mattbrejza/cubesat-pwr/board/power-board.brd

## EAGLE design board/power-board.brd (2018-11-06)

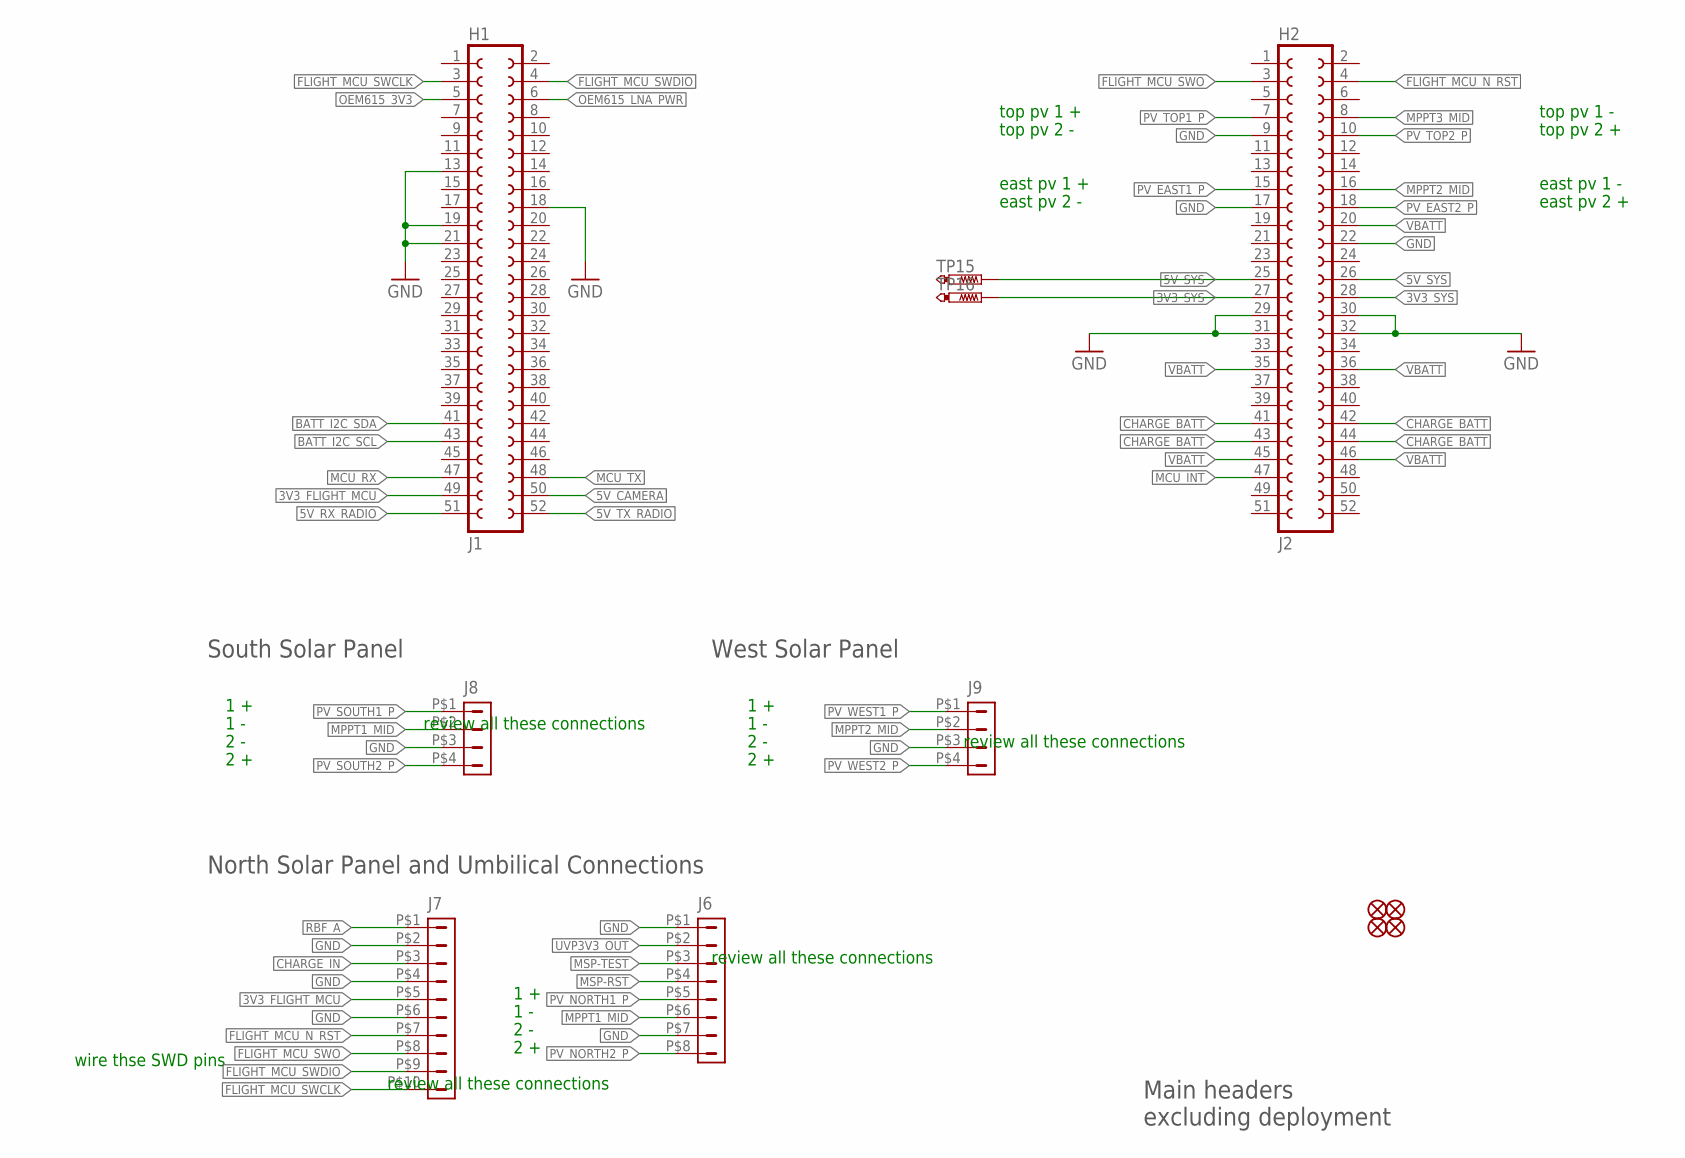
[picture p1: schematic power-board.sch, sheet 1, Headers H1, H2, Solar Panels and Umbilical Connection]

Parts:
FID1, FID2, FID3, FID4: FIDUCIAL1X2-STOP; FIDUCIAL-1X2-STOP
J1: H1; FE26-2
J2: H2; FE26-2
J6: DF13-8P-1.25DS
J7: DF13-10P-1.25DS
J8, J9: DF13-4P-1.25DS
TP15, TP16: PTR1TP09R; TP09R

Connections:
3V3_FLIGHT_MCU: J1.49, J7.P$5 (5); also elsewhere on the board
3V3_SYS: J2.27, J2.28, TP16.TP; also elsewhere on the board
5V_CAMERA: J1.50; also elsewhere on the board
5V_RX_RADIO: J1.51; also elsewhere on the board
5V_SYS: J2.25, J2.26, TP15.TP; also elsewhere on the board
5V_TX_RADIO: J1.52; also elsewhere on the board
BATT_I2C_SCL: J1.43; also elsewhere on the board
BATT_I2C_SDA: J1.41; also elsewhere on the board
CHARGE_BATT: J2.41, J2.42, J2.43, J2.44; also elsewhere on the board
CHARGE_IN: J7.P$3 (3); also elsewhere on the board
FLIGHT_MCU_N_RST: J2.4, J7.P$7 (7)
FLIGHT_MCU_SWCLK: J1.3, J7.P$10 (10)
FLIGHT_MCU_SWDIO: J1.4, J7.P$9 (9)
FLIGHT_MCU_SWO: J2.3, J7.P$8 (8)
GND: J1.13, J1.18, J1.19, J1.21, J2.9, J2.17, J2.22, J2.29, J2.30, J2.31, J2.32, J6.P$1 (1), J6.P$7 (7), J7.P$2 (2), J7.P$4 (4), J7.P$6 (6), J8.P$3 (3), J9.P$3 (3); also elsewhere on the board
MCU_INT: J2.47; also elsewhere on the board
MCU_RX: J1.47; also elsewhere on the board
MCU_TX: J1.48; also elsewhere on the board
MPPT1_MID: J6.P$6 (6), J8.P$2 (2); also elsewhere on the board
MPPT2_MID: J2.16, J9.P$2 (2); also elsewhere on the board
MPPT3_MID: J2.8; also elsewhere on the board
MSP-RST: J6.P$4 (4); also elsewhere on the board
MSP-TEST: J6.P$3 (3); also elsewhere on the board
OEM615_3V3: J1.5; also elsewhere on the board
OEM615_LNA_PWR: J1.6; also elsewhere on the board
PV_EAST1_P: J2.15; also elsewhere on the board
PV_EAST2_P: J2.18; also elsewhere on the board
PV_NORTH1_P: J6.P$5 (5); also elsewhere on the board
PV_NORTH2_P: J6.P$8 (8); also elsewhere on the board
PV_SOUTH1_P: J8.P$1 (1); also elsewhere on the board
PV_SOUTH2_P: J8.P$4 (4); also elsewhere on the board
PV_TOP1_P: J2.7; also elsewhere on the board
PV_TOP2_P: J2.10; also elsewhere on the board
PV_WEST1_P: J9.P$1 (1); also elsewhere on the board
PV_WEST2_P: J9.P$4 (4); also elsewhere on the board
RBF_A: J7.P$1 (1)
UVP3V3_OUT: J6.P$2 (2); also elsewhere on the board
VBATT: J2.20, J2.35, J2.36, J2.45, J2.46; also elsewhere on the board

Notes on the sheet:
South Solar Panel
West Solar Panel
North Solar Panel and Umbilical Connections
Main headers excluding deployment
review all these connections
top pv 1 -
east pv 1 -
east pv 2 +
top pv 2 +
wire thse SWD pins
top pv 1 +
top pv 2 -
east pv 1 +
east pv 2 -
1 +
1 -
2 +
2 -

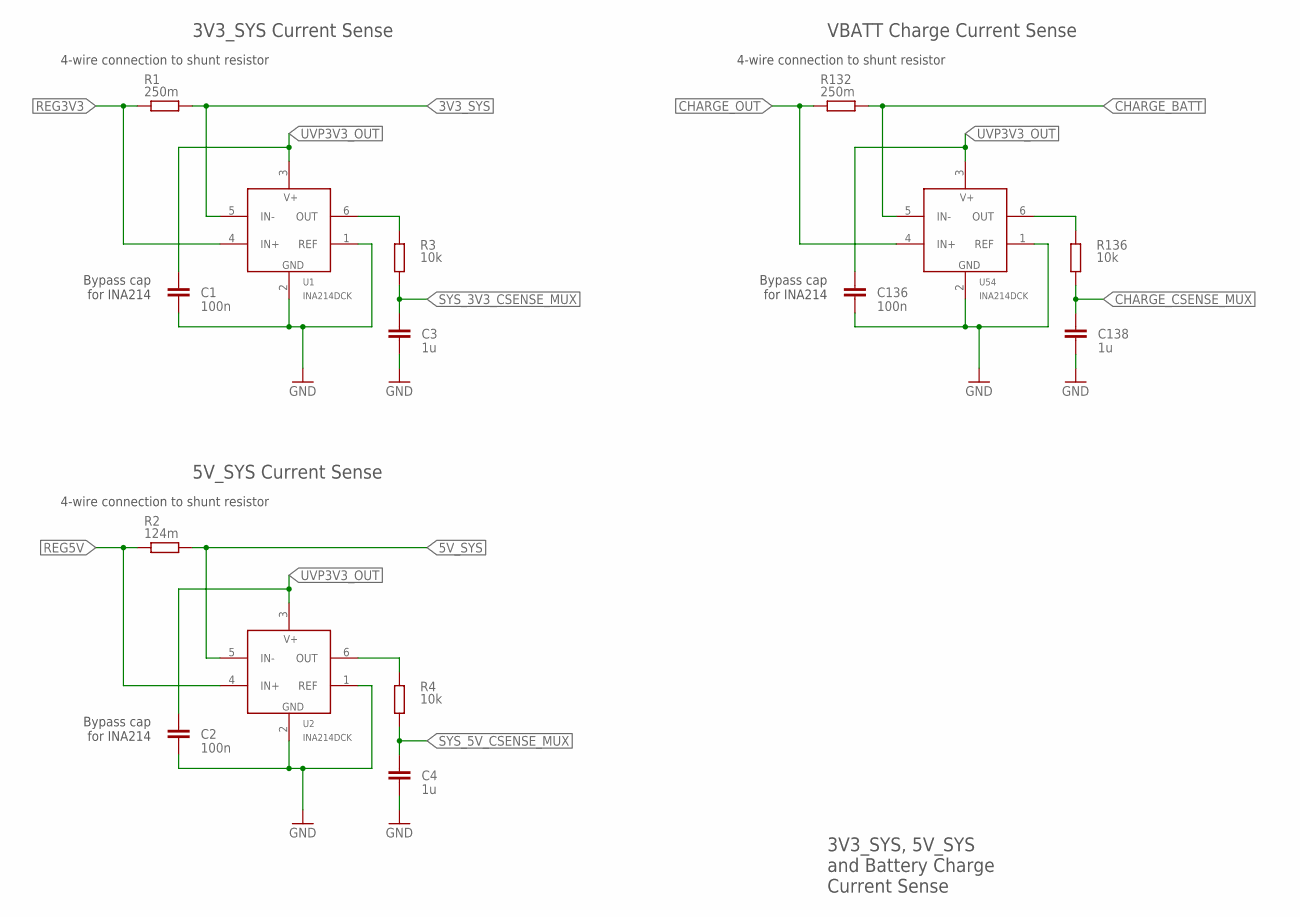
[picture p2: schematic power-board.sch, sheet 2, 3V3_SYS/5V_SYS/battery charge Current Sense]

Parts:
C1, C2, C136: 100n; C0603
C3, C4, C138: 1u; C0603
R1, R132: 250m; R1206
R2: 124m; R1206
R3, R4, R136: 10k; R0603
U1, U2, U54: INA214DCK; SC70-6

Connections:
3V3_SYS: R1.2, U1.5 (IN-); also elsewhere on the board
5V_SYS: R2.2, U2.5 (IN-); also elsewhere on the board
CHARGE_BATT: R132.2, U54.5 (IN-); also elsewhere on the board
CHARGE_CSENSE_MUX: C138.1, R136.1; also elsewhere on the board
CHARGE_OUT: R132.1, U54.4 (IN+); also elsewhere on the board
GND: C1.2, C2.2, C3.2, C4.2, C136.2, C138.2, U1.1 (REF), U1.2 (GND), U2.1 (REF), U2.2 (GND), U54.1 (REF), U54.2 (GND); also elsewhere on the board
unnamed: R3.2, U1.6 (OUT)
unnamed: R4.2, U2.6 (OUT)
unnamed: R136.2, U54.6 (OUT)
REG3V3: R1.1, U1.4 (IN+); also elsewhere on the board
REG5V: R2.1, U2.4 (IN+); also elsewhere on the board
SYS_3V3_CSENSE_MUX: C3.1, R3.1; also elsewhere on the board
SYS_5V_CSENSE_MUX: C4.1, R4.1; also elsewhere on the board
UVP3V3_OUT: C1.1, C2.1, C136.1, U1.3 (V+), U2.3 (V+), U54.3 (V+); also elsewhere on the board

Notes on the sheet:
4-wire connection to shunt resistor
Bypass cap for INA214
3V3_SYS, 5V_SYS and Battery Charge Current Sense
3V3_SYS Current Sense
5V_SYS Current Sense
VBATT Charge Current Sense

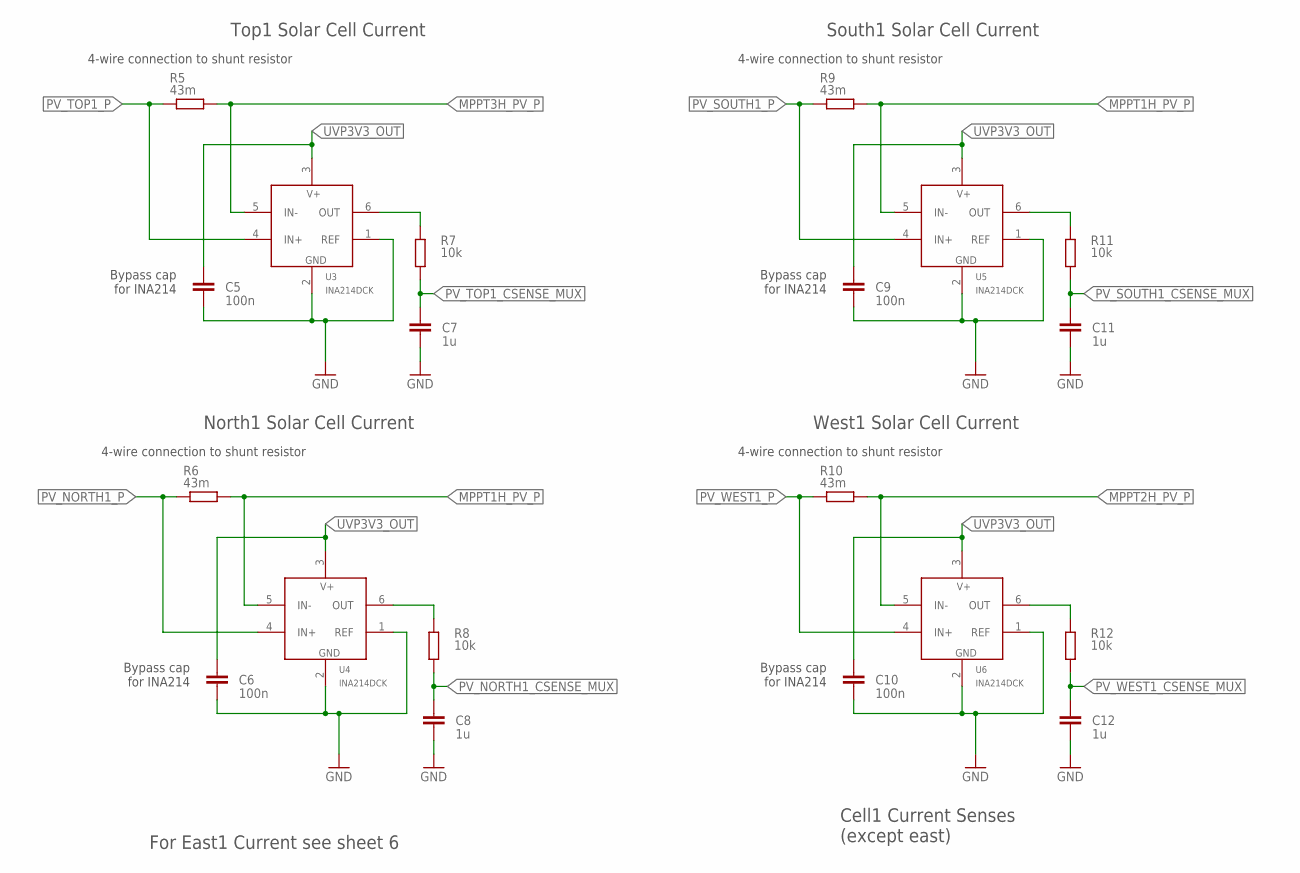
[picture p3: schematic power-board.sch, sheet 3, Solar Panel 1 Current Measurements]

Parts:
C5, C6, C9, C10: 100n; C0603
C7, C8, C11, C12: 1u; C0603
R5, R6, R9, R10: 43m; R1206
R7, R8, R11, R12: 10k; R0603
U3, U4, U5, U6: INA214DCK; SC70-6

Connections:
GND: C5.2, C6.2, C7.2, C8.2, C9.2, C10.2, C11.2, C12.2, U3.1 (REF), U3.2 (GND), U4.1 (REF), U4.2 (GND), U5.1 (REF), U5.2 (GND), U6.1 (REF), U6.2 (GND); also elsewhere on the board
MPPT1H_PV_P: R6.2, R9.2, U4.5 (IN-), U5.5 (IN-); also elsewhere on the board
MPPT2H_PV_P: R10.2, U6.5 (IN-); also elsewhere on the board
MPPT3H_PV_P: R5.2, U3.5 (IN-); also elsewhere on the board
unnamed: R7.2, U3.6 (OUT)
unnamed: R11.2, U5.6 (OUT)
unnamed: R8.2, U4.6 (OUT)
unnamed: R12.2, U6.6 (OUT)
PV_NORTH1_CSENSE_MUX: C8.1, R8.1; also elsewhere on the board
PV_NORTH1_P: R6.1, U4.4 (IN+); also elsewhere on the board
PV_SOUTH1_CSENSE_MUX: C11.1, R11.1; also elsewhere on the board
PV_SOUTH1_P: R9.1, U5.4 (IN+); also elsewhere on the board
PV_TOP1_CSENSE_MUX: C7.1, R7.1; also elsewhere on the board
PV_TOP1_P: R5.1, U3.4 (IN+); also elsewhere on the board
PV_WEST1_CSENSE_MUX: C12.1, R12.1; also elsewhere on the board
PV_WEST1_P: R10.1, U6.4 (IN+); also elsewhere on the board
UVP3V3_OUT: C5.1, C6.1, C9.1, C10.1, U3.3 (V+), U4.3 (V+), U5.3 (V+), U6.3 (V+); also elsewhere on the board

Notes on the sheet:
4-wire connection to shunt resistor
Bypass cap for INA214
Top1 Solar Cell Current
South1 Solar Cell Current
North1 Solar Cell Current
Cell1 Current Senses (except east)
West1 Solar Cell Current
For East1 Current see sheet 6

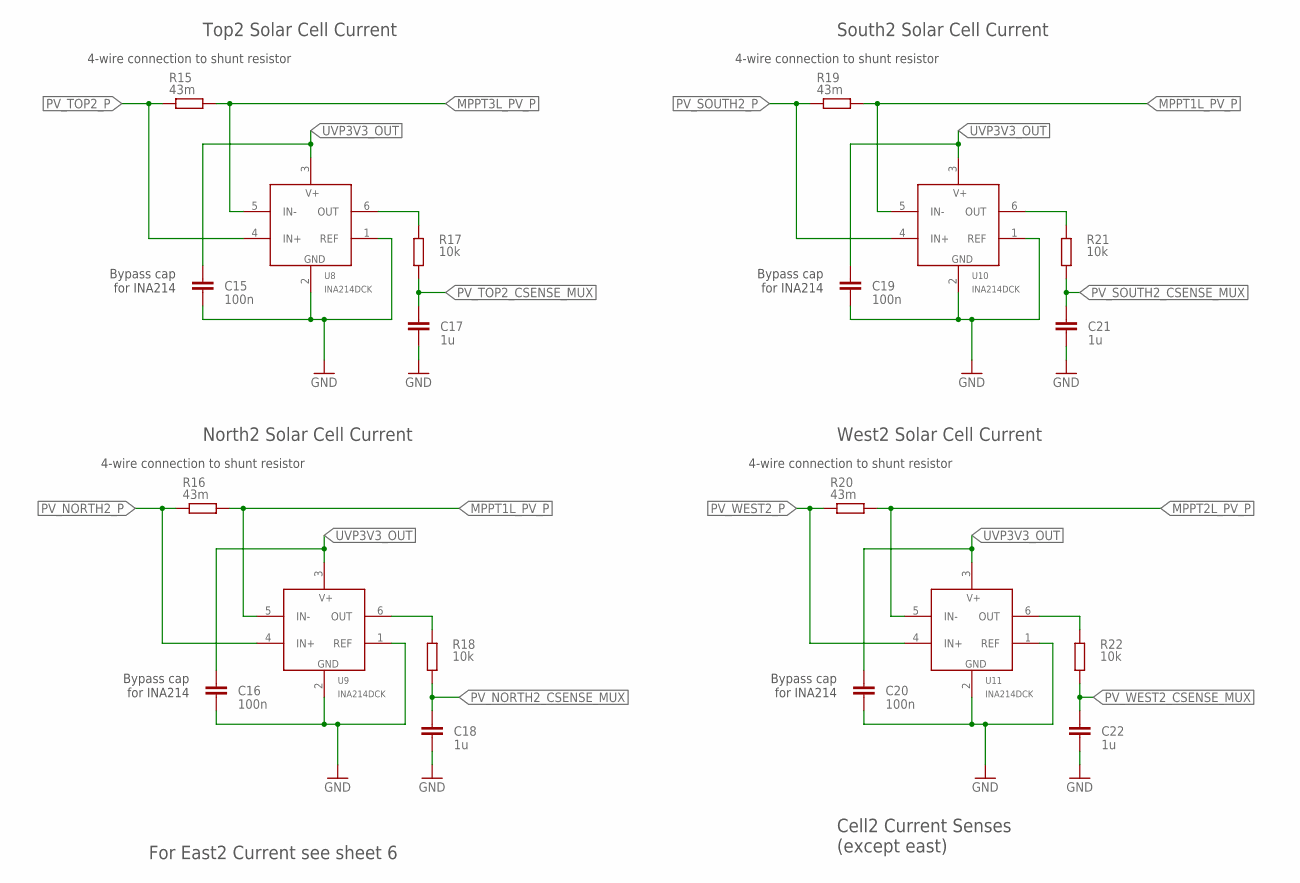
[picture p4: schematic power-board.sch, sheet 4, Solar Panel 2 Current Measurements]

Parts:
C15, C16, C19, C20: 100n; C0603
C17, C18, C21, C22: 1u; C0603
R15, R16, R19, R20: 43m; R1206
R17, R18, R21, R22: 10k; R0603
U8, U9, U10, U11: INA214DCK; SC70-6

Connections:
GND: C15.2, C16.2, C17.2, C18.2, C19.2, C20.2, C21.2, C22.2, U8.1 (REF), U8.2 (GND), U9.1 (REF), U9.2 (GND), U10.1 (REF), U10.2 (GND), U11.1 (REF), U11.2 (GND); also elsewhere on the board
MPPT1L_PV_P: R16.2, R19.2, U9.5 (IN-), U10.5 (IN-); also elsewhere on the board
MPPT2L_PV_P: R20.2, U11.5 (IN-); also elsewhere on the board
MPPT3L_PV_P: R15.2, U8.5 (IN-); also elsewhere on the board
unnamed: R17.2, U8.6 (OUT)
unnamed: R21.2, U10.6 (OUT)
unnamed: R18.2, U9.6 (OUT)
unnamed: R22.2, U11.6 (OUT)
PV_NORTH2_CSENSE_MUX: C18.1, R18.1; also elsewhere on the board
PV_NORTH2_P: R16.1, U9.4 (IN+); also elsewhere on the board
PV_SOUTH2_CSENSE_MUX: C21.1, R21.1; also elsewhere on the board
PV_SOUTH2_P: R19.1, U10.4 (IN+); also elsewhere on the board
PV_TOP2_CSENSE_MUX: C17.1, R17.1; also elsewhere on the board
PV_TOP2_P: R15.1, U8.4 (IN+); also elsewhere on the board
PV_WEST2_CSENSE_MUX: C22.1, R22.1; also elsewhere on the board
PV_WEST2_P: R20.1, U11.4 (IN+); also elsewhere on the board
UVP3V3_OUT: C15.1, C16.1, C19.1, C20.1, U8.3 (V+), U9.3 (V+), U10.3 (V+), U11.3 (V+); also elsewhere on the board

Notes on the sheet:
4-wire connection to shunt resistor
Bypass cap for INA214
Top2 Solar Cell Current
South2 Solar Cell Current
North2 Solar Cell Current
West2 Solar Cell Current
Cell2 Current Senses (except east)
For East2 Current see sheet 6

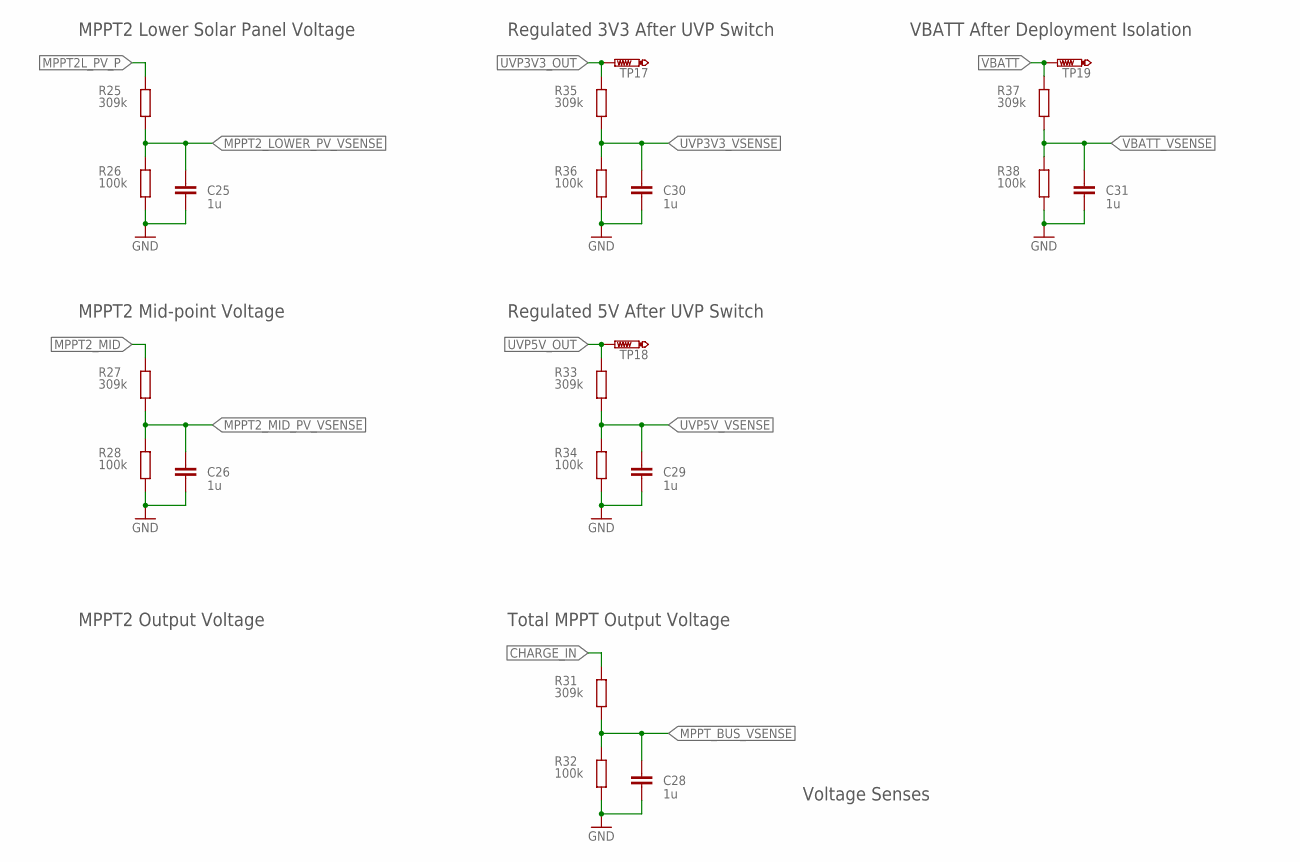
[picture p5: schematic power-board.sch, sheet 5, Voltage Measurements]

Parts:
C25, C26, C28, C29, C30, C31: 1u; C0603
R25, R27, R31, R33, R35, R37: 309k; R0603
R26, R28, R32, R34, R36, R38: 100k; R0603
TP17, TP18, TP19: PTR1TP09R; TP09R

Connections:
CHARGE_IN: R31.2; also elsewhere on the board
GND: C25.2, C26.2, C28.2, C29.2, C30.2, C31.2, R26.1, R28.1, R32.1, R34.1, R36.1, R38.1; also elsewhere on the board
MPPT2L_PV_P: R25.2; also elsewhere on the board
MPPT2_LOWER_PV_VSENSE: C25.1, R25.1, R26.2; also elsewhere on the board
MPPT2_MID: R27.2; also elsewhere on the board
MPPT2_MID_PV_VSENSE: C26.1, R27.1, R28.2; also elsewhere on the board
MPPT_BUS_VSENSE: C28.1, R31.1, R32.2; also elsewhere on the board
UVP3V3_OUT: R35.2, TP17.TP; also elsewhere on the board
UVP3V3_VSENSE: C30.1, R35.1, R36.2; also elsewhere on the board
UVP5V_OUT: R33.2, TP18.TP; also elsewhere on the board
UVP5V_VSENSE: C29.1, R33.1, R34.2; also elsewhere on the board
VBATT: R37.2, TP19.TP; also elsewhere on the board
VBATT_VSENSE: C31.1, R37.1, R38.2; also elsewhere on the board

Notes on the sheet:
MPPT2 Lower Solar Panel Voltage
MPPT2 Mid-point Voltage
Regulated 5V After UVP Switch
Regulated 3V3 After UVP Switch
MPPT2 Output Voltage
Total MPPT Output Voltage
VBATT After Deployment Isolation
Voltage Senses

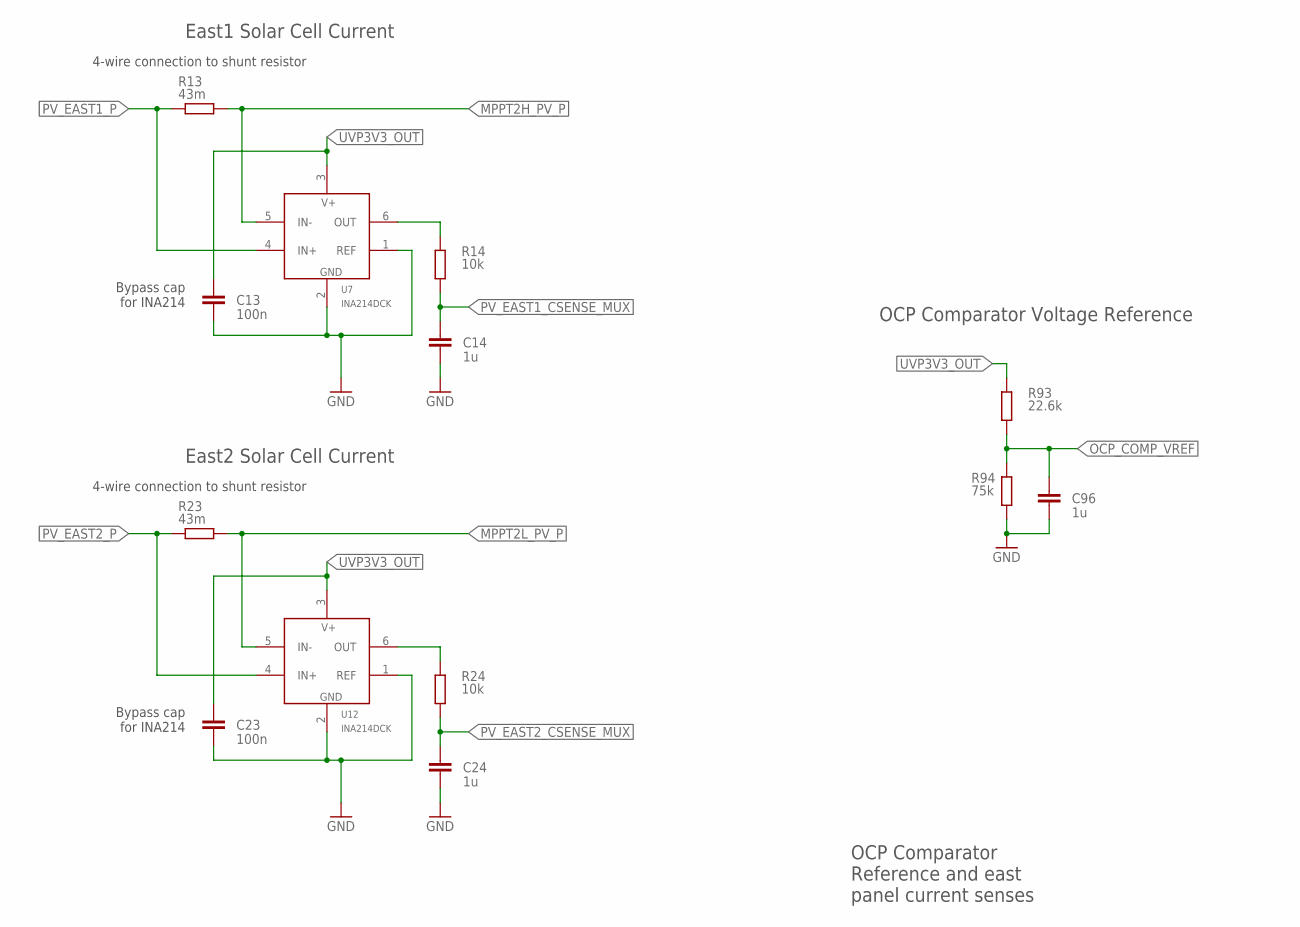
[picture p6: schematic power-board.sch, sheet 6, OCP Comparator Reference and East solar panel current sense]

Parts:
C13, C23: 100n; C0603
C14, C24, C96: 1u; C0603
R13, R23: 43m; R1206
R14, R24: 10k; R0603
R93: 22.6k; R0603
R94: 75k; R0603
U7, U12: INA214DCK; SC70-6

Connections:
GND: C13.2, C14.2, C23.2, C24.2, C96.2, R94.1, U7.1 (REF), U7.2 (GND), U12.1 (REF), U12.2 (GND); also elsewhere on the board
MPPT2H_PV_P: R13.2, U7.5 (IN-); also elsewhere on the board
MPPT2L_PV_P: R23.2, U12.5 (IN-); also elsewhere on the board
unnamed: R14.2, U7.6 (OUT)
unnamed: R24.2, U12.6 (OUT)
OCP_COMP_VREF: C96.1, R93.1, R94.2; also elsewhere on the board
PV_EAST1_CSENSE_MUX: C14.1, R14.1; also elsewhere on the board
PV_EAST1_P: R13.1, U7.4 (IN+); also elsewhere on the board
PV_EAST2_CSENSE_MUX: C24.1, R24.1; also elsewhere on the board
PV_EAST2_P: R23.1, U12.4 (IN+); also elsewhere on the board
UVP3V3_OUT: C13.1, C23.1, R93.2, U7.3 (V+), U12.3 (V+); also elsewhere on the board

Notes on the sheet:
4-wire connection to shunt resistor
Bypass cap for INA214
OCP Comparator Reference and east panel current senses
East1 Solar Cell Current
East2 Solar Cell Current
OCP Comparator Voltage Reference

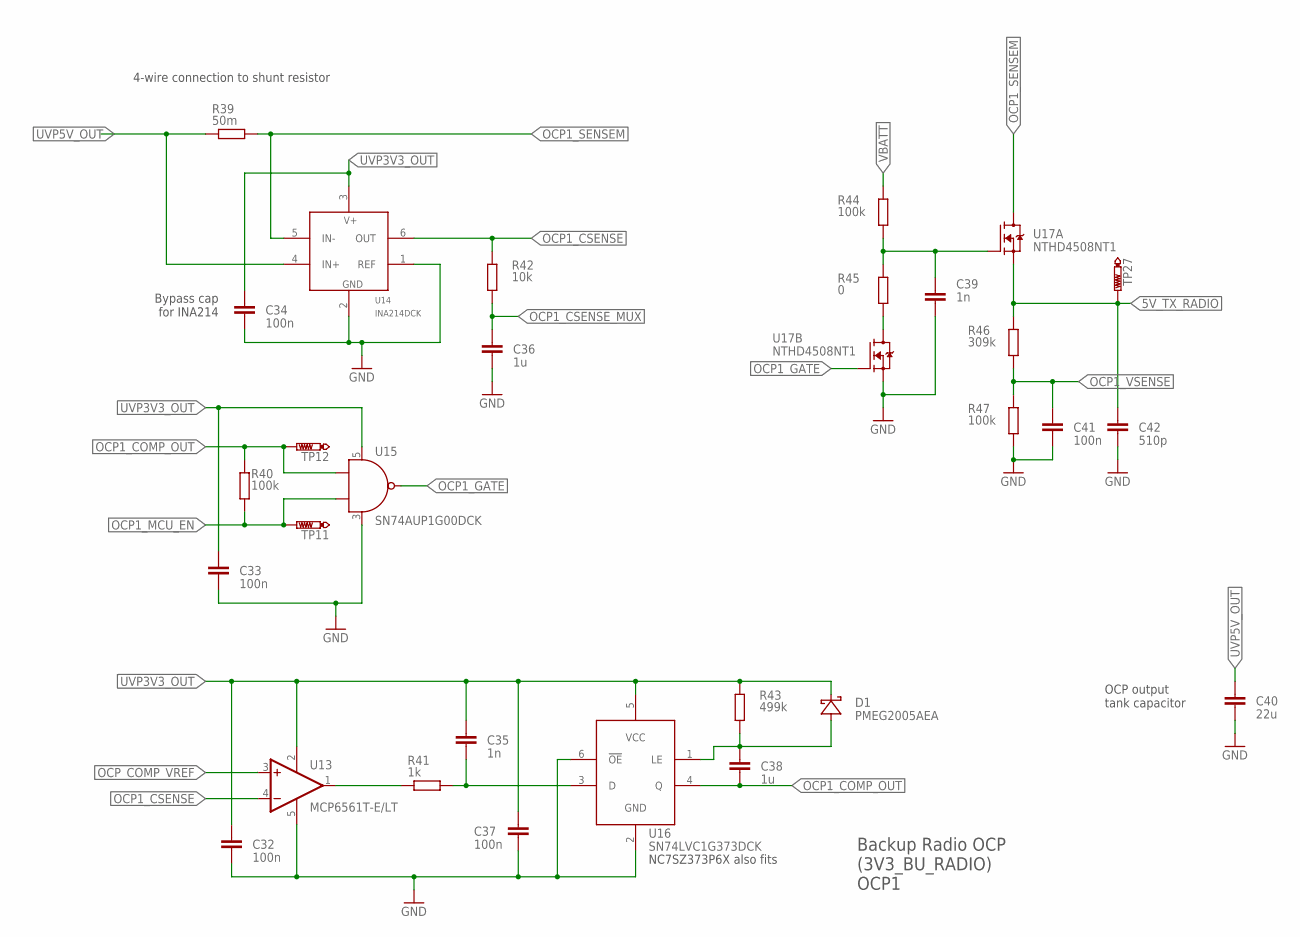
[picture p7: schematic power-board.sch, sheet 7, OCP1 5V_TX_RADIO]

Parts:
C32, C33, C34, C37, C41: 100n; C0603
C35, C39: 1n; C0603
C36, C38: 1u; C0603
C40: 22u; C1210
C42: 510p; C0603
D1: PMEG2005AEA; SOD-323
R39: 50m; R1206
R40, R44, R47: 100k; R0603
R41: 1k; R0603
R42: 10k; R0603
R43: 499k; R0603
R45: 0; R0603
R46: 309k; R0603
TP11, TP12, TP27: PTR1TP09R; TP09R
U13: MCP6561T-E/LT; SOT23-5
U14: INA214DCK; SC70-6
U15: SN74AUP1G00DCK; SC70-5
U16: SN74LVC1G373DCK; SC70-6
U17: NTHD4508NT1; CHIPFET-1206A-S2

Connections:
5V_TX_RADIO: C42.1, R46.2, TP27.TP, U17.1 (S); also elsewhere on the board
GND: C32.2, C33.2, C34.2, C36.2, C37.2, C39.2, C40.2, C41.2, C42.2, R47.1, U13.5 (V-), U14.1 (REF), U14.2 (GND), U15.3 (V-), U16.2 (GND), U16.6 (!OE), U17.3 (S); also elsewhere on the board
unnamed: C39.1, R44.1, R45.2, U17.2 (G)
unnamed: R45.1, U17.5 (D), U17.6 (D)
unnamed: C35.1, R41.2, U16.3 (D)
unnamed: R41.1, U13.1 (OUT)
unnamed: C38.1, D1.2 (A), R43.1, U16.1 (LE)
OCP1_COMP_OUT: C38.2, R40.2, TP12.TP, U15.1 (A), U16.4 (Q)
OCP1_CSENSE: R42.2, U13.4 (-IN), U14.6 (OUT)
OCP1_CSENSE_MUX: C36.1, R42.1; also elsewhere on the board
OCP1_GATE: U15.4 (Y), U17.4 (G)
OCP1_MCU_EN: R40.1, TP11.TP, U15.2 (B); also elsewhere on the board
OCP1_SENSEM: R39.2, U14.5 (IN-), U17.7 (D), U17.8 (D)
OCP1_VSENSE: C41.1, R46.1, R47.2; also elsewhere on the board
OCP_COMP_VREF: U13.3 (+IN); also elsewhere on the board
UVP3V3_OUT: C32.1, C33.1, C34.1, C35.2, C37.1, D1.1 (C), R43.2, U13.2 (V+), U14.3 (V+), U15.5 (V+), U16.5 (VCC); also elsewhere on the board
UVP5V_OUT: C40.1, R39.1, U14.4 (IN+); also elsewhere on the board
VBATT: R44.2; also elsewhere on the board

Notes on the sheet:
NC7SZ373P6X also fits
4-wire connection to shunt resistor
Bypass cap for INA214
OCP output tank capacitor
Backup Radio OCP (3V3_BU_RADIO) OCP1

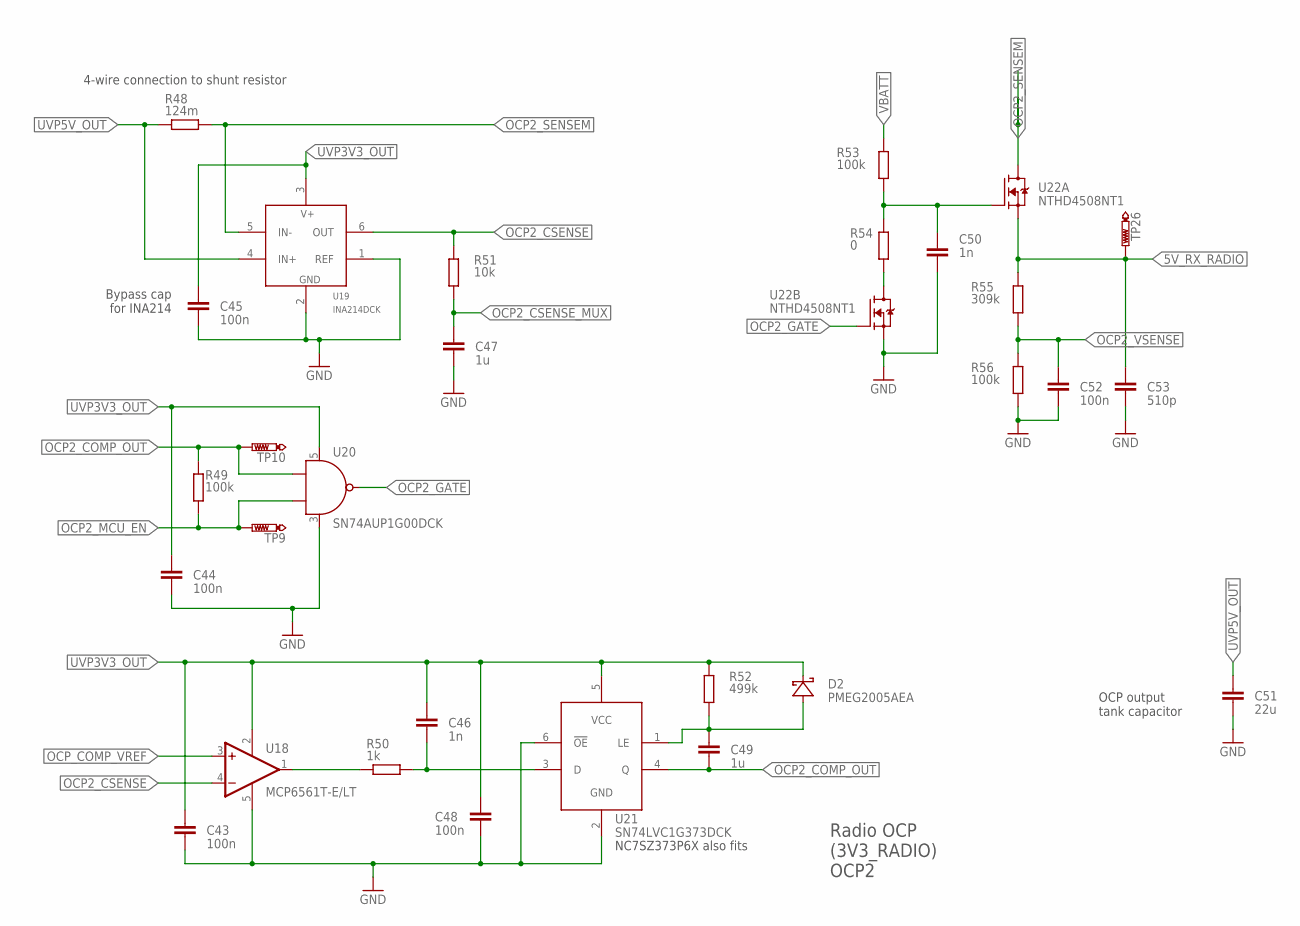
[picture p8: schematic power-board.sch, sheet 8, OCP2 5V_RX_RADIO]

Parts:
C43, C44, C45, C48, C52: 100n; C0603
C46, C50: 1n; C0603
C47, C49: 1u; C0603
C51: 22u; C1210
C53: 510p; C0603
D2: PMEG2005AEA; SOD-323
R48: 124m; R1206
R49, R53, R56: 100k; R0603
R50: 1k; R0603
R51: 10k; R0603
R52: 499k; R0603
R54: 0; R0603
R55: 309k; R0603
TP9, TP10, TP26: PTR1TP09R; TP09R
U18: MCP6561T-E/LT; SOT23-5
U19: INA214DCK; SC70-6
U20: SN74AUP1G00DCK; SC70-5
U21: SN74LVC1G373DCK; SC70-6
U22: NTHD4508NT1; CHIPFET-1206A-S2

Connections:
5V_RX_RADIO: C53.1, R55.2, TP26.TP, U22.1 (S); also elsewhere on the board
GND: C43.2, C44.2, C45.2, C47.2, C48.2, C50.2, C51.2, C52.2, C53.2, R56.1, U18.5 (V-), U19.1 (REF), U19.2 (GND), U20.3 (V-), U21.2 (GND), U21.6 (!OE), U22.3 (S); also elsewhere on the board
unnamed: R54.1, U22.5 (D), U22.6 (D)
unnamed: C46.1, R50.2, U21.3 (D)
unnamed: R50.1, U18.1 (OUT)
unnamed: C49.1, D2.2 (A), R52.1, U21.1 (LE)
unnamed: C50.1, R53.1, R54.2, U22.2 (G)
OCP2_COMP_OUT: C49.2, R49.2, TP10.TP, U20.1 (A), U21.4 (Q)
OCP2_CSENSE: R51.2, U18.4 (-IN), U19.6 (OUT)
OCP2_CSENSE_MUX: C47.1, R51.1; also elsewhere on the board
OCP2_GATE: U20.4 (Y), U22.4 (G)
OCP2_MCU_EN: R49.1, TP9.TP, U20.2 (B); also elsewhere on the board
OCP2_SENSEM: R48.2, U19.5 (IN-), U22.7 (D), U22.8 (D)
OCP2_VSENSE: C52.1, R55.1, R56.2; also elsewhere on the board
OCP_COMP_VREF: U18.3 (+IN); also elsewhere on the board
UVP3V3_OUT: C43.1, C44.1, C45.1, C46.2, C48.1, D2.1 (C), R52.2, U18.2 (V+), U19.3 (V+), U20.5 (V+), U21.5 (VCC); also elsewhere on the board
UVP5V_OUT: C51.1, R48.1, U19.4 (IN+); also elsewhere on the board
VBATT: R53.2; also elsewhere on the board

Notes on the sheet:
NC7SZ373P6X also fits
4-wire connection to shunt resistor
Bypass cap for INA214
OCP output tank capacitor
Radio OCP (3V3_RADIO) OCP2

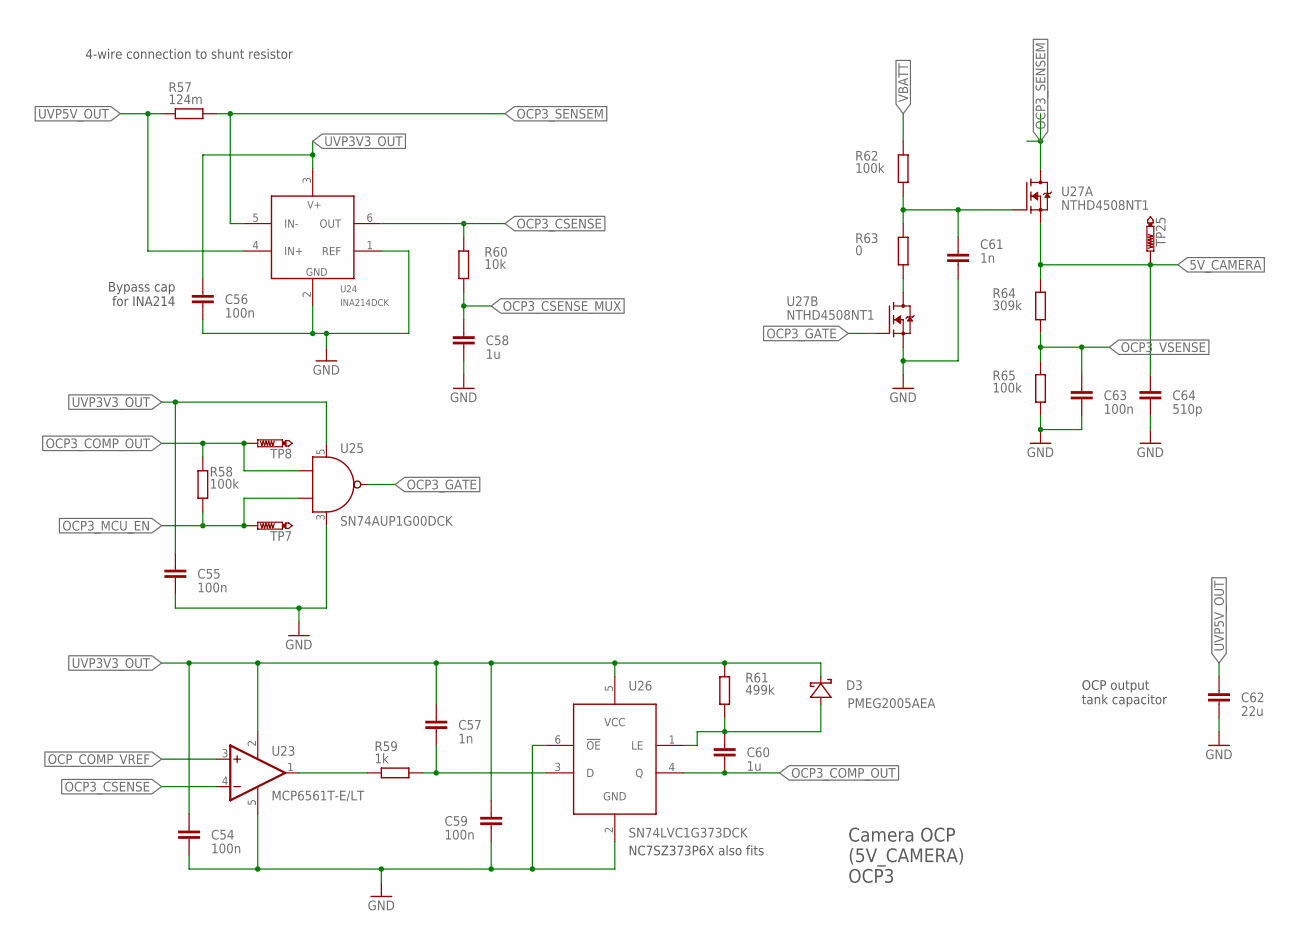
[picture p9: schematic power-board.sch, sheet 9, OCP3 5V Camera]

Parts:
C54, C55, C56, C59, C63: 100n; C0603
C57, C61: 1n; C0603
C58, C60: 1u; C0603
C62: 22u; C1210
C64: 510p; C0603
D3: PMEG2005AEA; SOD-323
R57: 124m; R1206
R58, R62, R65: 100k; R0603
R59: 1k; R0603
R60: 10k; R0603
R61: 499k; R0603
R63: 0; R0603
R64: 309k; R0603
TP7, TP8, TP25: PTR1TP09R; TP09R
U23: MCP6561T-E/LT; SOT23-5
U24: INA214DCK; SC70-6
U25: SN74AUP1G00DCK; SC70-5
U26: SN74LVC1G373DCK; SC70-6
U27: NTHD4508NT1; CHIPFET-1206A-S2

Connections:
5V_CAMERA: C64.1, R64.2, TP25.TP, U27.1 (S); also elsewhere on the board
GND: C54.2, C55.2, C56.2, C58.2, C59.2, C61.2, C62.2, C63.2, C64.2, R65.1, U23.5 (V-), U24.1 (REF), U24.2 (GND), U25.3 (V-), U26.2 (GND), U26.6 (!OE), U27.3 (S); also elsewhere on the board
unnamed: R63.1, U27.5 (D), U27.6 (D)
unnamed: C57.1, R59.2, U26.3 (D)
unnamed: R59.1, U23.1 (OUT)
unnamed: C60.1, D3.2 (A), R61.1, U26.1 (LE)
unnamed: C61.1, R62.1, R63.2, U27.2 (G)
OCP3_COMP_OUT: C60.2, R58.2, TP8.TP, U25.1 (A), U26.4 (Q)
OCP3_CSENSE: R60.2, U23.4 (-IN), U24.6 (OUT)
OCP3_CSENSE_MUX: C58.1, R60.1; also elsewhere on the board
OCP3_GATE: U25.4 (Y), U27.4 (G)
OCP3_MCU_EN: R58.1, TP7.TP, U25.2 (B); also elsewhere on the board
OCP3_SENSEM: R57.2, U24.5 (IN-), U27.7 (D), U27.8 (D)
OCP3_VSENSE: C63.1, R64.1, R65.2; also elsewhere on the board
OCP_COMP_VREF: U23.3 (+IN); also elsewhere on the board
UVP3V3_OUT: C54.1, C55.1, C56.1, C57.2, C59.1, D3.1 (C), R61.2, U23.2 (V+), U24.3 (V+), U25.5 (V+), U26.5 (VCC); also elsewhere on the board
UVP5V_OUT: C62.1, R57.1, U24.4 (IN+); also elsewhere on the board
VBATT: R62.2; also elsewhere on the board

Notes on the sheet:
NC7SZ373P6X also fits
4-wire connection to shunt resistor
Bypass cap for INA214
OCP output tank capacitor
Camera OCP (5V_CAMERA) OCP3

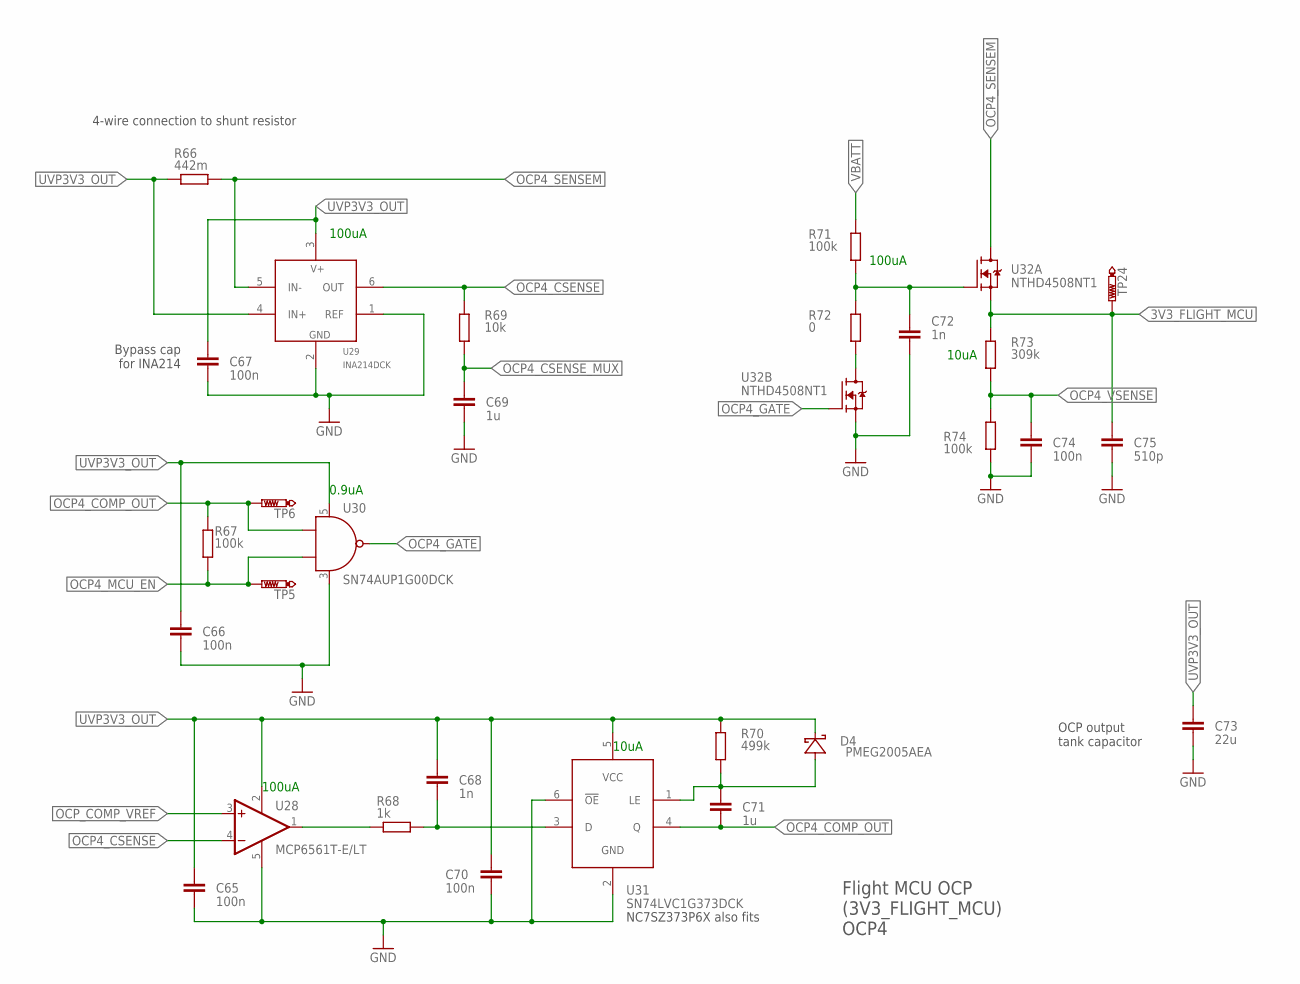
[picture p10: schematic power-board.sch, sheet 10, OCP4 3V3_FLIGHT_MCU]

Parts:
C65, C66, C67, C70, C74: 100n; C0603
C68, C72: 1n; C0603
C69, C71: 1u; C0603
C73: 22u; C1210
C75: 510p; C0603
D4: PMEG2005AEA; SOD-323
R66: 442m; R1206
R67, R71, R74: 100k; R0603
R68: 1k; R0603
R69: 10k; R0603
R70: 499k; R0603
R72: 0; R0603
R73: 309k; R0603
TP5, TP6, TP24: PTR1TP09R; TP09R
U28: MCP6561T-E/LT; SOT23-5
U29: INA214DCK; SC70-6
U30: SN74AUP1G00DCK; SC70-5
U31: SN74LVC1G373DCK; SC70-6
U32: NTHD4508NT1; CHIPFET-1206A-S2

Connections:
3V3_FLIGHT_MCU: C75.1, R73.2, TP24.TP, U32.1 (S); also elsewhere on the board
GND: C65.2, C66.2, C67.2, C69.2, C70.2, C72.2, C73.2, C74.2, C75.2, R74.1, U28.5 (V-), U29.1 (REF), U29.2 (GND), U30.3 (V-), U31.2 (GND), U31.6 (!OE), U32.3 (S); also elsewhere on the board
unnamed: R72.1, U32.5 (D), U32.6 (D)
unnamed: C68.1, R68.2, U31.3 (D)
unnamed: R68.1, U28.1 (OUT)
unnamed: C71.1, D4.2 (A), R70.1, U31.1 (LE)
unnamed: C72.1, R71.1, R72.2, U32.2 (G)
OCP4_COMP_OUT: C71.2, R67.2, TP6.TP, U30.1 (A), U31.4 (Q)
OCP4_CSENSE: R69.2, U28.4 (-IN), U29.6 (OUT)
OCP4_CSENSE_MUX: C69.1, R69.1; also elsewhere on the board
OCP4_GATE: U30.4 (Y), U32.4 (G)
OCP4_MCU_EN: R67.1, TP5.TP, U30.2 (B); also elsewhere on the board
OCP4_SENSEM: R66.2, U29.5 (IN-), U32.7 (D), U32.8 (D)
OCP4_VSENSE: C74.1, R73.1, R74.2; also elsewhere on the board
OCP_COMP_VREF: U28.3 (+IN); also elsewhere on the board
UVP3V3_OUT: C65.1, C66.1, C67.1, C68.2, C70.1, C73.1, D4.1 (C), R66.1, R70.2, U28.2 (V+), U29.3 (V+), U29.4 (IN+), U30.5 (V+), U31.5 (VCC); also elsewhere on the board
VBATT: R71.2; also elsewhere on the board

Notes on the sheet:
NC7SZ373P6X also fits
4-wire connection to shunt resistor
Bypass cap for INA214
OCP output tank capacitor
Flight MCU OCP (3V3_FLIGHT_MCU) OCP4
100uA
0.9uA
10uA
