mattbrejza/cubesat-pwr/board/power-board.brd

## EAGLE design board/power-board.brd (continued)

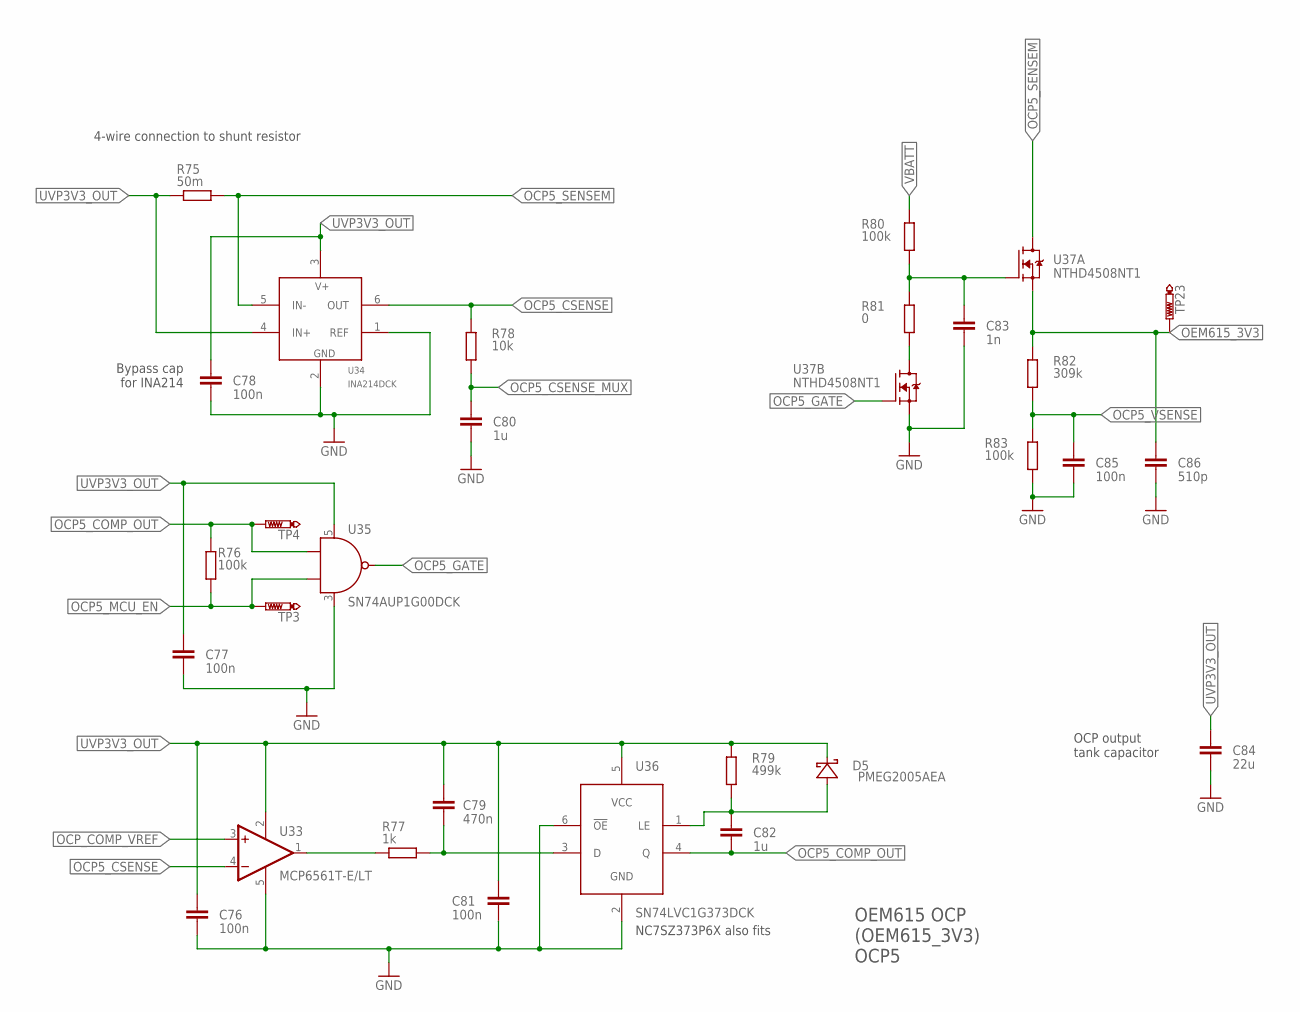
[picture p11: schematic power-board.sch, sheet 11, OCP5 OEM615_3V3]

Parts:
C76, C77, C78, C81, C85: 100n; C0603
C79: 470n; C0603
C80, C82: 1u; C0603
C83: 1n; C0603
C84: 22u; C1210
C86: 510p; C0603
D5: PMEG2005AEA; SOD-323
R75: 50m; R1206
R76, R80, R83: 100k; R0603
R77: 1k; R0603
R78: 10k; R0603
R79: 499k; R0603
R81: 0; R0603
R82: 309k; R0603
TP3, TP4, TP23: PTR1TP09R; TP09R
U33: MCP6561T-E/LT; SOT23-5
U34: INA214DCK; SC70-6
U35: SN74AUP1G00DCK; SC70-5
U36: SN74LVC1G373DCK; SC70-6
U37: NTHD4508NT1; CHIPFET-1206A-S2

Connections:
GND: C76.2, C77.2, C78.2, C80.2, C81.2, C83.2, C84.2, C85.2, C86.2, R83.1, U33.5 (V-), U34.1 (REF), U34.2 (GND), U35.3 (V-), U36.2 (GND), U36.6 (!OE), U37.3 (S); also elsewhere on the board
unnamed: R81.1, U37.5 (D), U37.6 (D)
unnamed: C79.1, R77.2, U36.3 (D)
unnamed: R77.1, U33.1 (OUT)
unnamed: C82.1, D5.2 (A), R79.1, U36.1 (LE)
unnamed: C83.1, R80.1, R81.2, U37.2 (G)
OCP5_COMP_OUT: C82.2, R76.2, TP4.TP, U35.1 (A), U36.4 (Q)
OCP5_CSENSE: R78.2, U33.4 (-IN), U34.6 (OUT)
OCP5_CSENSE_MUX: C80.1, R78.1; also elsewhere on the board
OCP5_GATE: U35.4 (Y), U37.4 (G)
OCP5_MCU_EN: R76.1, TP3.TP, U35.2 (B); also elsewhere on the board
OCP5_SENSEM: R75.2, U34.5 (IN-), U37.7 (D), U37.8 (D)
OCP5_VSENSE: C85.1, R82.1, R83.2; also elsewhere on the board
OCP_COMP_VREF: U33.3 (+IN); also elsewhere on the board
OEM615_3V3: C86.1, R82.2, TP23.TP, U37.1 (S); also elsewhere on the board
UVP3V3_OUT: C76.1, C77.1, C78.1, C79.2, C81.1, C84.1, D5.1 (C), R75.1, R79.2, U33.2 (V+), U34.3 (V+), U34.4 (IN+), U35.5 (V+), U36.5 (VCC); also elsewhere on the board
VBATT: R80.2; also elsewhere on the board

Notes on the sheet:
NC7SZ373P6X also fits
4-wire connection to shunt resistor
Bypass cap for INA214
OCP output tank capacitor
OEM615 OCP (OEM615_3V3) OCP5

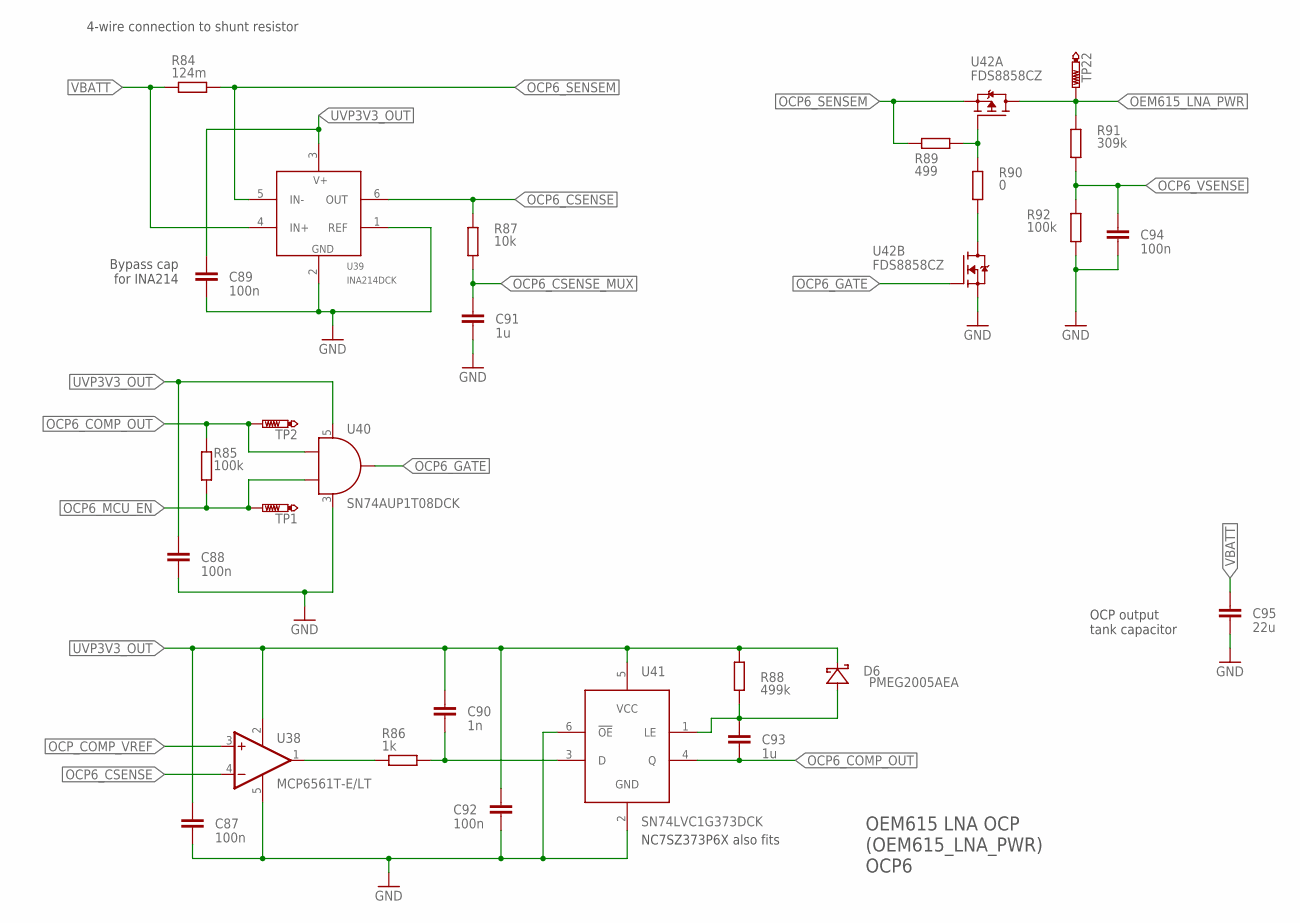
[picture p12: schematic power-board.sch, sheet 12, OCP6 GPS LNA (OEM615_LNA_PWR)<br\> Powered from VBATT (afte…]

Parts:
C87, C88, C89, C92, C94: 100n; C0603
C90: 1n; C0603
C91, C93: 1u; C0603
C95: 22u; C1210
D6: PMEG2005AEA; SOD-323
R84: 124m; R1206
R85, R92: 100k; R0603
R86: 1k; R0603
R87: 10k; R0603
R88: 499k; R0603
R89: 499; R0603
R90: 0; R0603
R91: 309k; R0603
TP1, TP2, TP22: PTR1TP09R; TP09R
U38: MCP6561T-E/LT; SOT23-5
U39: INA214DCK; SC70-6
U40: SN74AUP1T08DCK; SC70-5
U41: SN74LVC1G373DCK; SC70-6
U42: FDS8858CZ; SO8

Connections:
GND: C87.2, C88.2, C89.2, C91.2, C92.2, C94.2, C95.2, R92.1, U38.5 (V-), U39.1 (REF), U39.2 (GND), U40.3 (V-), U41.2 (GND), U41.6 (!OE), U42.1 (S); also elsewhere on the board
unnamed: C90.1, R86.2, U41.3 (D)
unnamed: R86.1, U38.1 (OUT)
unnamed: C93.1, D6.2 (A), R88.1, U41.1 (LE)
unnamed: R89.2, R90.2, U42.4 (G)
unnamed: R90.1, U42.7 (D), U42.8 (D)
OCP6_COMP_OUT: C93.2, R85.2, TP2.TP, U40.1 (A), U41.4 (Q)
OCP6_CSENSE: R87.2, U38.4 (-IN), U39.6 (OUT)
OCP6_CSENSE_MUX: C91.1, R87.1; also elsewhere on the board
OCP6_GATE: U40.4 (Y), U42.2 (G)
OCP6_MCU_EN: R85.1, TP1.TP, U40.2 (B); also elsewhere on the board
OCP6_SENSEM: R84.2, R89.1, U39.5 (IN-), U42.3 (S)
OCP6_VSENSE: C94.1, R91.1, R92.2; also elsewhere on the board
OCP_COMP_VREF: U38.3 (+IN); also elsewhere on the board
OEM615_LNA_PWR: R91.2, TP22.TP, U42.5 (D), U42.6 (D); also elsewhere on the board
UVP3V3_OUT: C87.1, C88.1, C89.1, C90.2, C92.1, D6.1 (C), R88.2, U38.2 (V+), U39.3 (V+), U40.5 (V+), U41.5 (VCC); also elsewhere on the board
VBATT: C95.1, R84.1, U39.4 (IN+); also elsewhere on the board

Notes on the sheet:
NC7SZ373P6X also fits
4-wire connection to shunt resistor
Bypass cap for INA214
OCP output tank capacitor
OEM615 LNA OCP (OEM615_LNA_PWR) OCP6

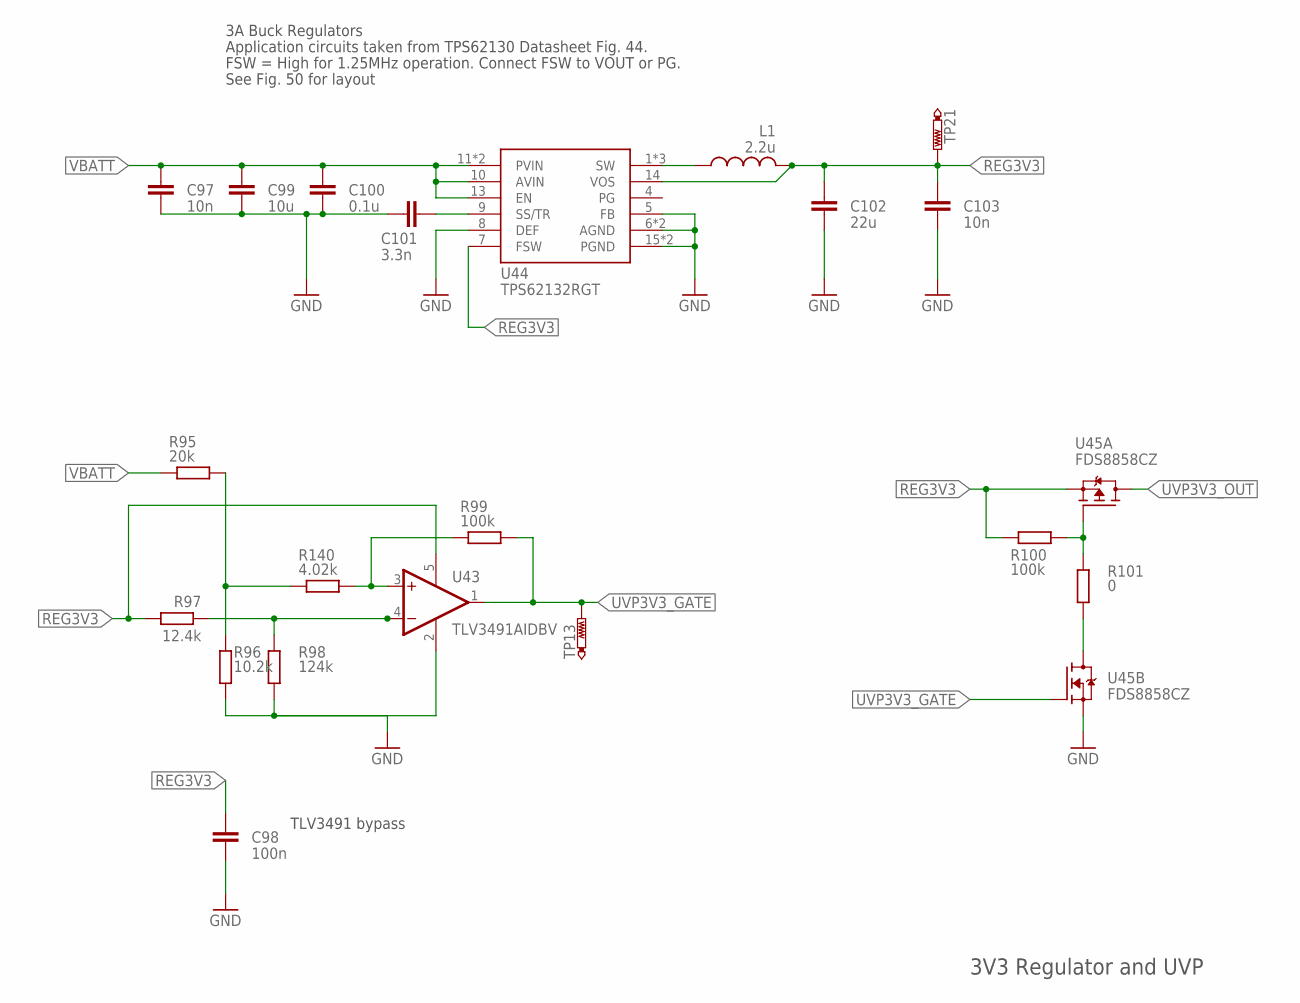
[picture p13: schematic power-board.sch, sheet 13, 3V3 Regulator and UVP]

Parts:
C97, C103: 10n; C0603
C98: 100n; C0603
C99: 10u; C1206
C100: 0.1u; C0603
C101: 3.3n; C0603
C102: 22u; C1210
L1: 2.2u; VISHAY-INDUCTOR
R95: 20k; R0603
R96: 10.2k; R0603
R97: 12.4k; R0603
R98: 124k; R0603
R99, R100: 100k; R0603
R101: 0; R0603
R140: 4.02k; R0603
TP13, TP21: PTR1TP09R; TP09R
U43: TLV3491AIDBV; SOT23-5
U44: TPS62132RGT; RGT.16
U45: FDS8858CZ; SO8

Connections:
GND: C97.2, C98.2, C99.2, C100.2, C101.1, C102.2, C103.2, R96.1, R98.1, U43.2 (V-), U44.5 (FB), U44.6 (AGND), U44.8 (DEF), U44.15 (PGND), U44.16 (PGND), U44.PAD (AGND), U45.1 (S); also elsewhere on the board
unnamed: C101.2, U44.9 (SS/TR)
unnamed: L1.1, U44.1 (SW), U44.2 (SW), U44.3 (SW)
unnamed: R101.1, U45.7 (D), U45.8 (D)
unnamed: R95.2, R96.2, R140.1
unnamed: R99.1, R140.2, U43.3 (+IN)
unnamed: R100.2, R101.2, U45.4 (G)
unnamed: R97.1, R98.2, U43.4 (-IN)
REG3V3: C98.1, C102.1, C103.1, L1.2, R97.2, R100.1, TP21.TP, U43.5 (V+), U44.7 (FSW), U44.14 (VOS), U45.3 (S); also elsewhere on the board
UVP3V3_GATE: R99.2, TP13.TP, U43.1 (OUT), U45.2 (G)
UVP3V3_OUT: U45.5 (D), U45.6 (D); also elsewhere on the board
VBATT: C97.1, C99.1, C100.1, R95.1, U44.10 (AVIN), U44.11 (PVIN), U44.12 (PVIN), U44.13 (EN); also elsewhere on the board

Notes on the sheet:
Application circuits taken from TPS62130 Datasheet Fig. 44.
FSW = High for 1.25MHz operation. Connect FSW to VOUT or PG.
See Fig. 50 for layout
3A Buck Regulators
TLV3491 bypass
3V3 Regulator and UVP

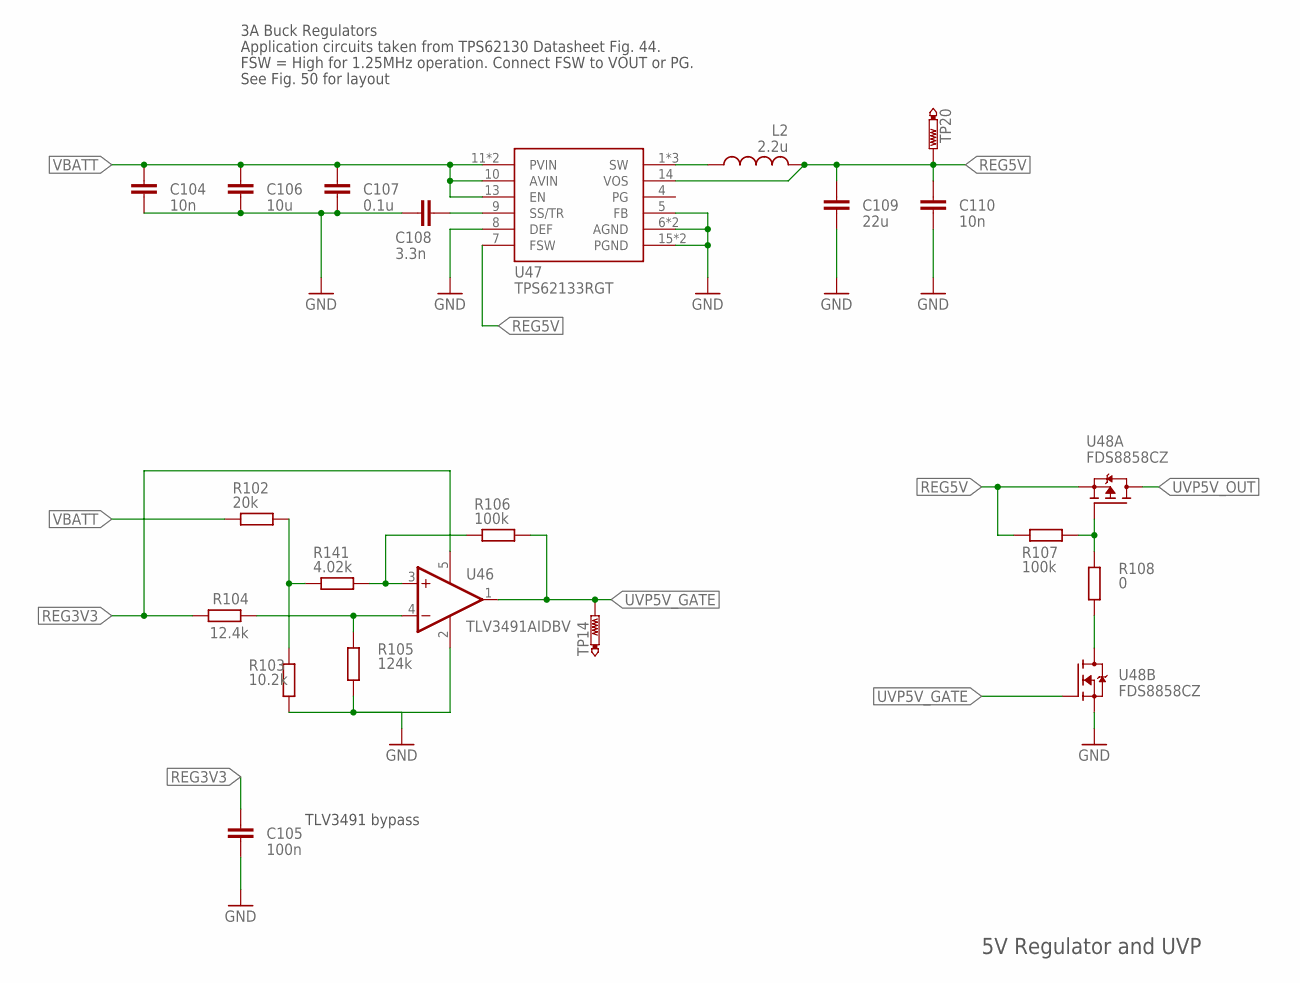
[picture p14: schematic power-board.sch, sheet 14, 5V Regulator and UVP]

Parts:
C104, C110: 10n; C0603
C105: 100n; C0603
C106: 10u; C1206
C107: 0.1u; C0603
C108: 3.3n; C0603
C109: 22u; C1210
L2: 2.2u; VISHAY-INDUCTOR
R102: 20k; R0603
R103: 10.2k; R0603
R104: 12.4k; R0603
R105: 124k; R0603
R106, R107: 100k; R0603
R108: 0; R0603
R141: 4.02k; R0603
TP14, TP20: PTR1TP09R; TP09R
U46: TLV3491AIDBV; SOT23-5
U47: TPS62133RGT; RGT.16
U48: FDS8858CZ; SO8

Connections:
GND: C104.2, C105.2, C106.2, C107.2, C108.1, C109.2, C110.2, R103.1, R105.1, U46.2 (V-), U47.5 (FB), U47.6 (AGND), U47.8 (DEF), U47.15 (PGND), U47.16 (PGND), U47.PAD (AGND), U48.1 (S); also elsewhere on the board
unnamed: C108.2, U47.9 (SS/TR)
unnamed: L2.1, U47.1 (SW), U47.2 (SW), U47.3 (SW)
unnamed: R107.2, R108.2, U48.4 (G)
unnamed: R102.2, R103.2, R141.1
unnamed: R106.1, R141.2, U46.3 (+IN)
unnamed: R108.1, U48.7 (D), U48.8 (D)
unnamed: R104.1, R105.2, U46.4 (-IN)
REG3V3: C105.1, R104.2, U46.5 (V+); also elsewhere on the board
REG5V: C109.1, C110.1, L2.2, R107.1, TP20.TP, U47.7 (FSW), U47.14 (VOS), U48.3 (S); also elsewhere on the board
UVP5V_GATE: R106.2, TP14.TP, U46.1 (OUT), U48.2 (G)
UVP5V_OUT: U48.5 (D), U48.6 (D); also elsewhere on the board
VBATT: C104.1, C106.1, C107.1, R102.1, U47.10 (AVIN), U47.11 (PVIN), U47.12 (PVIN), U47.13 (EN); also elsewhere on the board

Notes on the sheet:
Application circuits taken from TPS62130 Datasheet Fig. 44.
FSW = High for 1.25MHz operation. Connect FSW to VOUT or PG.
See Fig. 50 for layout
3A Buck Regulators
TLV3491 bypass
5V Regulator and UVP

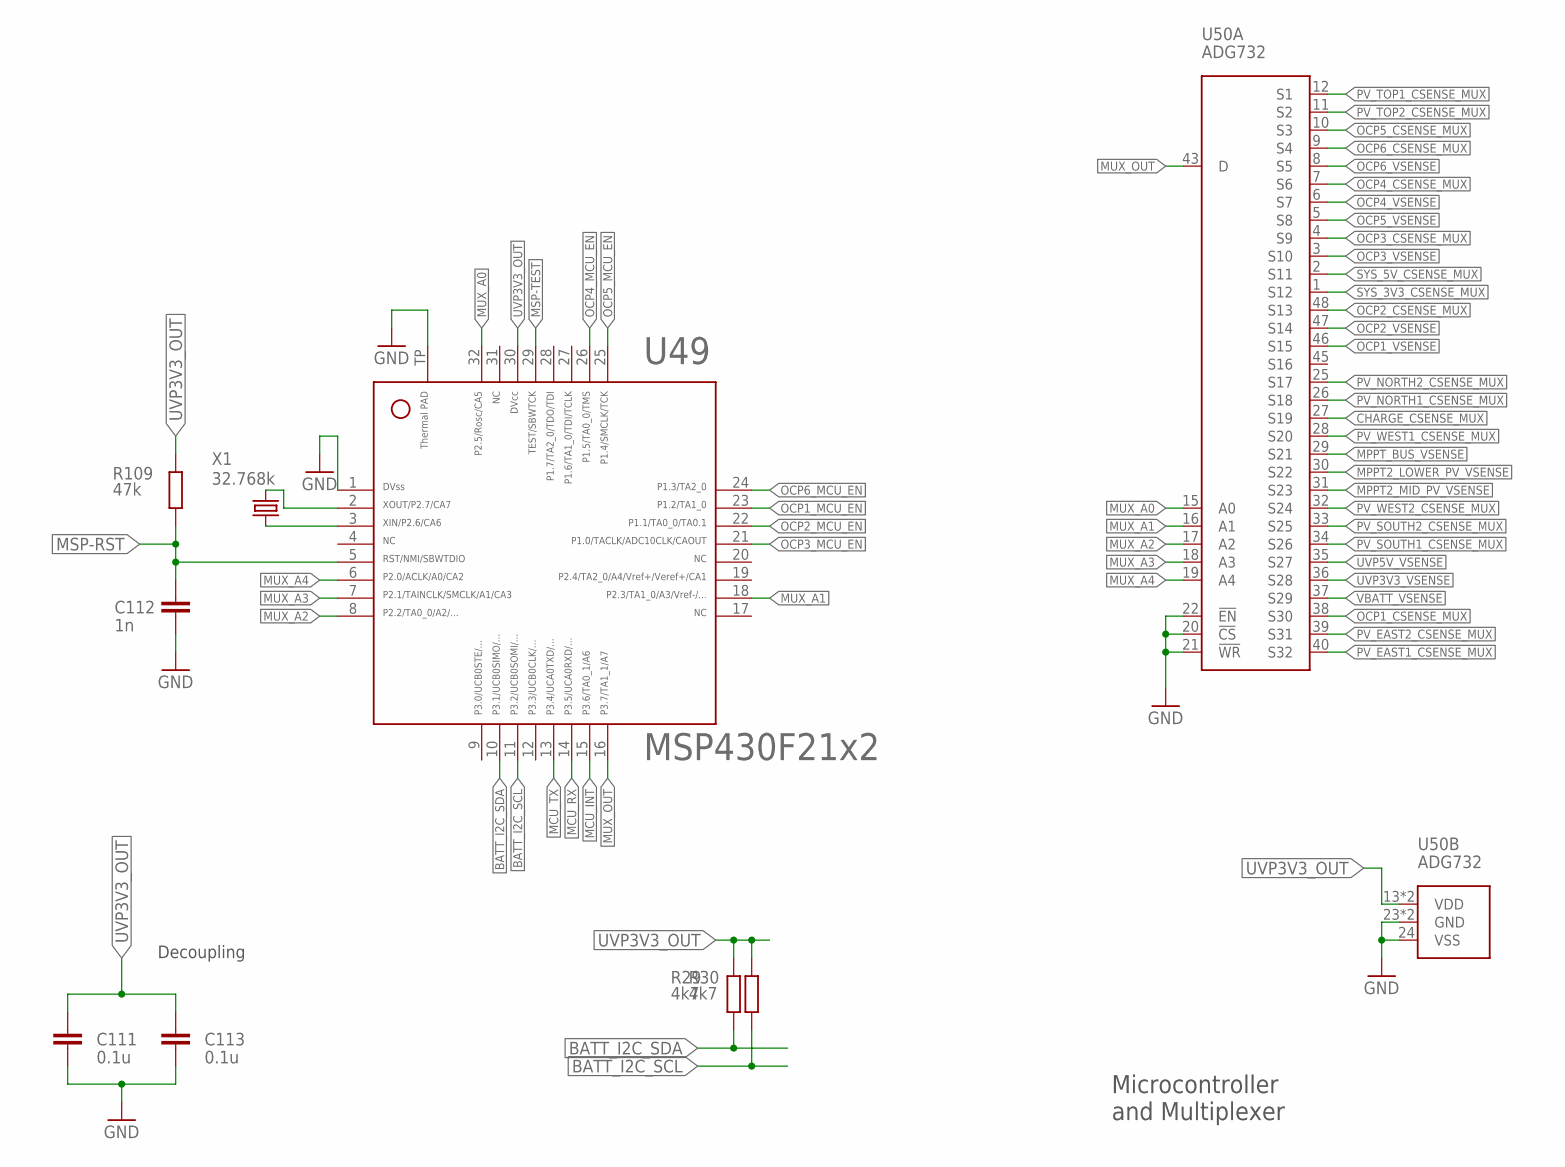
[picture p15: schematic power-board.sch, sheet 15, MCU and MUX]

Parts:
C111, C113: 0.1u; C0603K
C112: 1n; C0603K
R29, R30: 4k7; R0603
R109: 47k; R0603
U49: MSP430F2132; RHB32
U50: ADG732; LFCSP48
X1: 32.768k; CC7V-T1A

Connections:
BATT_I2C_SCL: R30.1, U49.11; also elsewhere on the board
BATT_I2C_SDA: R29.1, U49.10; also elsewhere on the board
CHARGE_CSENSE_MUX: U50.27 (S19); also elsewhere on the board
GND: C111.2, C112.2, C113.2, U49.1, U49.TP (33), U50.20 (!CS), U50.21 (!WR), U50.22 (!EN), U50.23 (GND), U50.24 (VSS), U50.EXP (GND); also elsewhere on the board
MCU_INT: U49.15; also elsewhere on the board
MCU_RX: U49.14; also elsewhere on the board
MCU_TX: U49.13; also elsewhere on the board
MPPT2_LOWER_PV_VSENSE: U50.30 (S22); also elsewhere on the board
MPPT2_MID_PV_VSENSE: U50.31 (S23); also elsewhere on the board
MPPT_BUS_VSENSE: U50.29 (S21); also elsewhere on the board
MSP-RST: C112.1, R109.1, U49.5; also elsewhere on the board
MSP-TEST: U49.29; also elsewhere on the board
MUX_A0: U49.32, U50.15 (A0)
MUX_A1: U49.18, U50.16 (A1)
MUX_A2: U49.8, U50.17 (A2)
MUX_A3: U49.7, U50.18 (A3)
MUX_A4: U49.6, U50.19 (A4)
MUX_OUT: U49.16, U50.43 (D)
unnamed: U49.2, X1.P$2 (2)
unnamed: U49.3, X1.P$1 (1)
OCP1_CSENSE_MUX: U50.38 (S30); also elsewhere on the board
OCP1_MCU_EN: U49.23; also elsewhere on the board
OCP1_VSENSE: U50.46 (S15); also elsewhere on the board
OCP2_CSENSE_MUX: U50.48 (S13); also elsewhere on the board
OCP2_MCU_EN: U49.22; also elsewhere on the board
OCP2_VSENSE: U50.47 (S14); also elsewhere on the board
OCP3_CSENSE_MUX: U50.4 (S9); also elsewhere on the board
OCP3_MCU_EN: U49.21; also elsewhere on the board
OCP3_VSENSE: U50.3 (S10); also elsewhere on the board
OCP4_CSENSE_MUX: U50.7 (S6); also elsewhere on the board
OCP4_MCU_EN: U49.26; also elsewhere on the board
OCP4_VSENSE: U50.6 (S7); also elsewhere on the board
OCP5_CSENSE_MUX: U50.10 (S3); also elsewhere on the board
OCP5_MCU_EN: U49.25; also elsewhere on the board
OCP5_VSENSE: U50.5 (S8); also elsewhere on the board
OCP6_CSENSE_MUX: U50.9 (S4); also elsewhere on the board
OCP6_MCU_EN: U49.24; also elsewhere on the board
OCP6_VSENSE: U50.8 (S5); also elsewhere on the board
PV_EAST1_CSENSE_MUX: U50.40 (S32); also elsewhere on the board
PV_EAST2_CSENSE_MUX: U50.39 (S31); also elsewhere on the board
PV_NORTH1_CSENSE_MUX: U50.26 (S18); also elsewhere on the board
PV_NORTH2_CSENSE_MUX: U50.25 (S17); also elsewhere on the board
PV_SOUTH1_CSENSE_MUX: U50.34 (S26); also elsewhere on the board
PV_SOUTH2_CSENSE_MUX: U50.33 (S25); also elsewhere on the board
PV_TOP1_CSENSE_MUX: U50.12 (S1); also elsewhere on the board
PV_TOP2_CSENSE_MUX: U50.11 (S2); also elsewhere on the board
PV_WEST1_CSENSE_MUX: U50.28 (S20); also elsewhere on the board
PV_WEST2_CSENSE_MUX: U50.32 (S24); also elsewhere on the board
SYS_3V3_CSENSE_MUX: U50.1 (S12); also elsewhere on the board
SYS_5V_CSENSE_MUX: U50.2 (S11); also elsewhere on the board
UVP3V3_OUT: C111.1, C113.1, R29.2, R30.2, R109.2, U49.30, U50.13 (VDD), U50.14 (VDD); also elsewhere on the board
UVP3V3_VSENSE: U50.36 (S28); also elsewhere on the board
UVP5V_VSENSE: U50.35 (S27); also elsewhere on the board
VBATT_VSENSE: U50.37 (S29); also elsewhere on the board

Notes on the sheet:
Decoupling
Microcontroller and Multiplexer

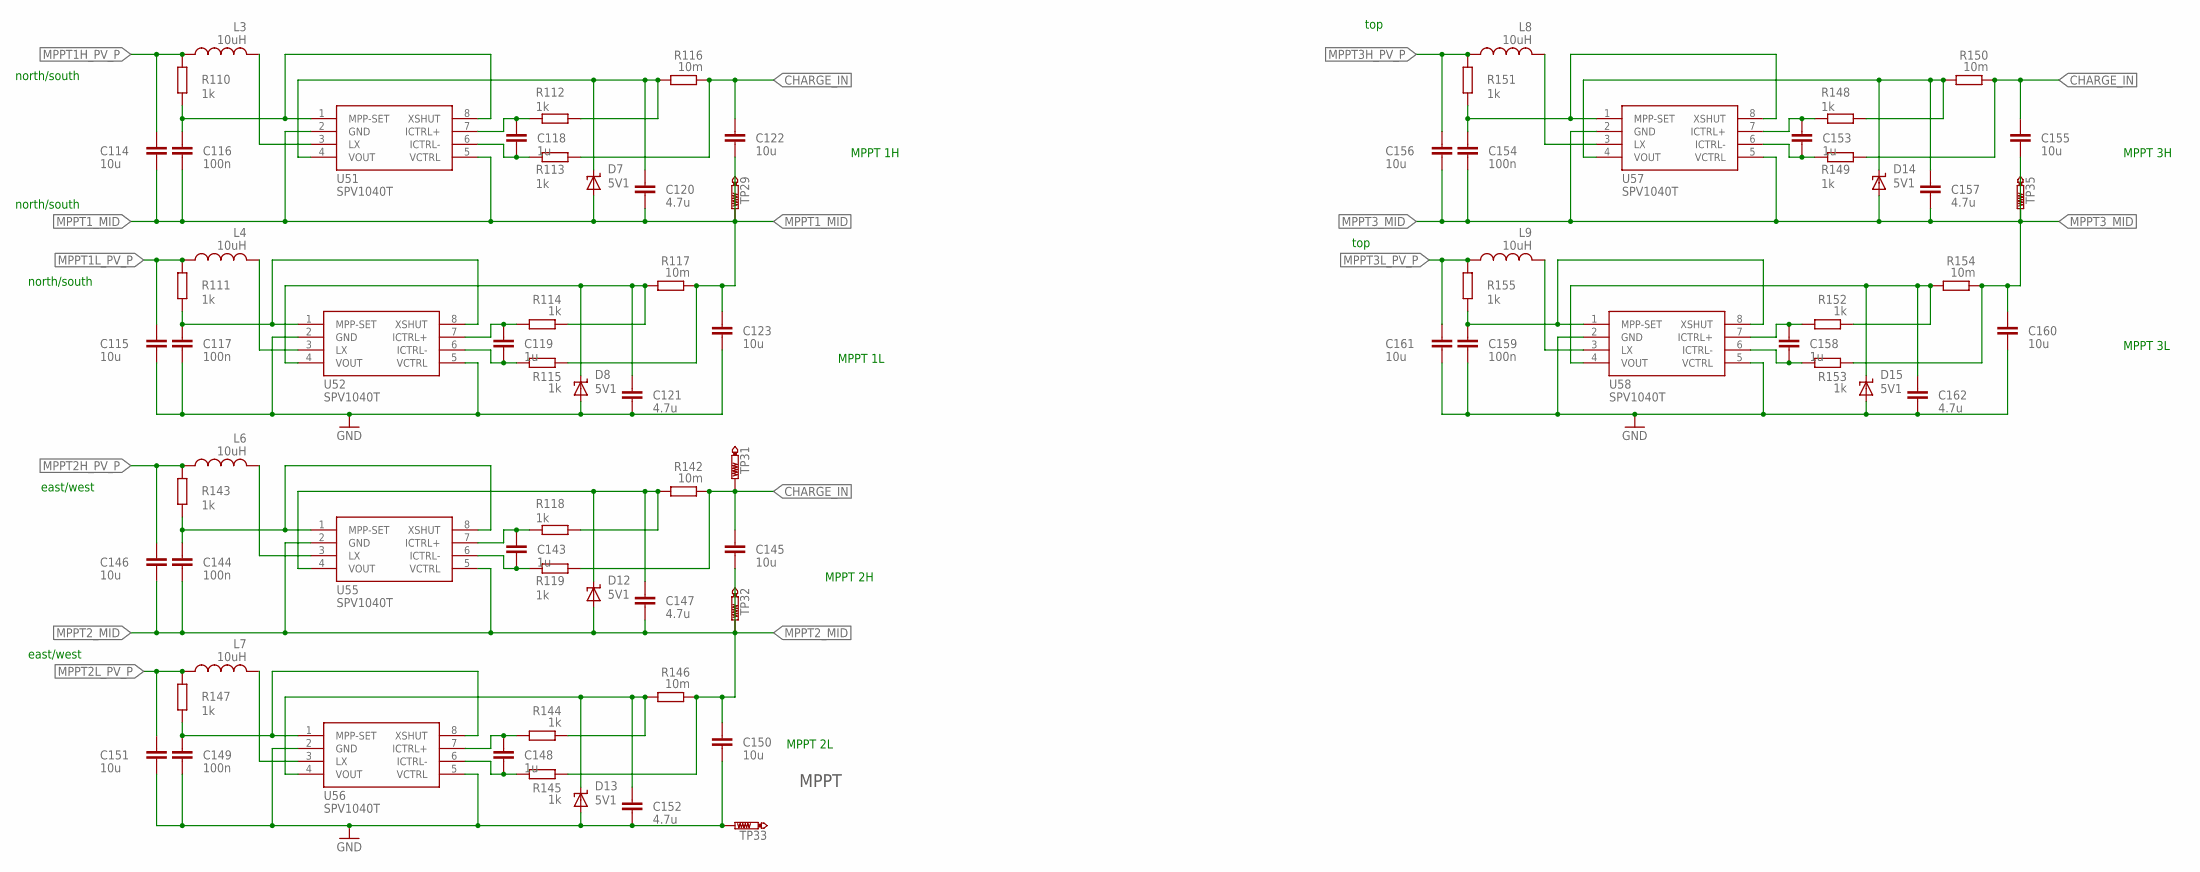
[picture p16: schematic power-board.sch, sheet 16, MPPT]

Parts:
C114, C115, C122, C123, C145, C146, C150, C151, C155, C156, C160, C161: 10u; C0805K
C116, C117, C144, C149, C154, C159: 100n; C0603K
C118, C119, C143, C148, C153, C158: 1u; C0603K
C120, C121, C147, C152, C157, C162: 4.7u; C0805K
D7, D8, D12, D13, D14, D15: 5V1; SMBJ
L3, L4, L6, L7, L8, L9: 10uH; MSS7341
R110, R111, R112, R113, R114, R115, R118, R119, R143, R144, R145, R147, R148, R149, R151, R152, R153, R155: 1k; R0603
R116, R117, R142, R146, R150, R154: 10m; R1206
TP29, TP31, TP32, TP33, TP35: PTR1TP09R; TP09R
U51, U52, U55, U56, U57, U58: SPV1040T; TSSOP8

Connections:
CHARGE_IN: C122.1, C145.1, C155.1, R113.1, R116.1, R119.1, R142.1, R149.1, R150.1, TP31.TP; also elsewhere on the board
GND: C115.2, C117.2, C121.2, C123.2, C149.2, C150.2, C151.2, C152.2, C159.2, C160.2, C161.2, C162.2, D8.A, D13.A, D15.A, TP33.TP, U52.2 (GND), U52.5 (VCTRL), U56.2 (GND), U56.5 (VCTRL), U58.2 (GND), U58.5 (VCTRL); also elsewhere on the board
MPPT1H_PV_P: C114.1, L3.1, R110.1; also elsewhere on the board
MPPT1L_PV_P: C115.1, L4.1, R111.1; also elsewhere on the board
MPPT1_MID: C114.2, C116.2, C120.2, C122.2, C123.1, D7.A, R115.1, R117.1, TP29.TP, U51.2 (GND), U51.5 (VCTRL); also elsewhere on the board
MPPT2H_PV_P: C146.1, L6.1, R143.1; also elsewhere on the board
MPPT2L_PV_P: C151.1, L7.1, R147.1; also elsewhere on the board
MPPT2_MID: C144.2, C145.2, C146.2, C147.2, C150.1, D12.A, R145.1, R146.1, TP32.TP, U55.2 (GND), U55.5 (VCTRL); also elsewhere on the board
MPPT3H_PV_P: C156.1, L8.1, R151.1; also elsewhere on the board
MPPT3L_PV_P: C161.1, L9.1, R155.1; also elsewhere on the board
MPPT3_MID: C154.2, C155.2, C156.2, C157.2, C160.1, D14.A, R153.1, R154.1, TP35.TP, U57.2 (GND), U57.5 (VCTRL); also elsewhere on the board
unnamed: C118.1, R112.2, U51.7 (ICTRL+)
unnamed: C118.2, R113.2, U51.6 (ICTRL-)
unnamed: C120.1, D7.C, R112.1, R116.2, U51.4 (VOUT)
unnamed: C116.1, R110.2, U51.1 (MPP-SET), U51.8 (XSHUT)
unnamed: L3.2, U51.3 (LX)
unnamed: C143.1, R118.2, U55.7 (ICTRL+)
unnamed: C143.2, R119.2, U55.6 (ICTRL-)
unnamed: C147.1, D12.C, R118.1, R142.2, U55.4 (VOUT)
unnamed: C119.1, R114.2, U52.7 (ICTRL+)
unnamed: C119.2, R115.2, U52.6 (ICTRL-)
unnamed: C121.1, D8.C, R114.1, R117.2, U52.4 (VOUT)
unnamed: C117.1, R111.2, U52.1 (MPP-SET), U52.8 (XSHUT)
unnamed: L4.2, U52.3 (LX)
unnamed: C144.1, R143.2, U55.1 (MPP-SET), U55.8 (XSHUT)
unnamed: L6.2, U55.3 (LX)
unnamed: C148.1, R144.2, U56.7 (ICTRL+)
unnamed: C148.2, R145.2, U56.6 (ICTRL-)
unnamed: C152.1, D13.C, R144.1, R146.2, U56.4 (VOUT)
unnamed: C149.1, R147.2, U56.1 (MPP-SET), U56.8 (XSHUT)
unnamed: L7.2, U56.3 (LX)
unnamed: C153.1, R148.2, U57.7 (ICTRL+)
unnamed: C153.2, R149.2, U57.6 (ICTRL-)
unnamed: C157.1, D14.C, R148.1, R150.2, U57.4 (VOUT)
unnamed: C154.1, R151.2, U57.1 (MPP-SET), U57.8 (XSHUT)
unnamed: L8.2, U57.3 (LX)
unnamed: C158.1, R152.2, U58.7 (ICTRL+)
unnamed: C158.2, R153.2, U58.6 (ICTRL-)
unnamed: C162.1, D15.C, R152.1, R154.2, U58.4 (VOUT)
unnamed: C159.1, R155.2, U58.1 (MPP-SET), U58.8 (XSHUT)
unnamed: L9.2, U58.3 (LX)

Notes on the sheet:
MPPT
MPPT 1H
MPPT 1L
MPPT 2L
MPPT 3L
MPPT 3H
MPPT 2H
north/south
east/west
top

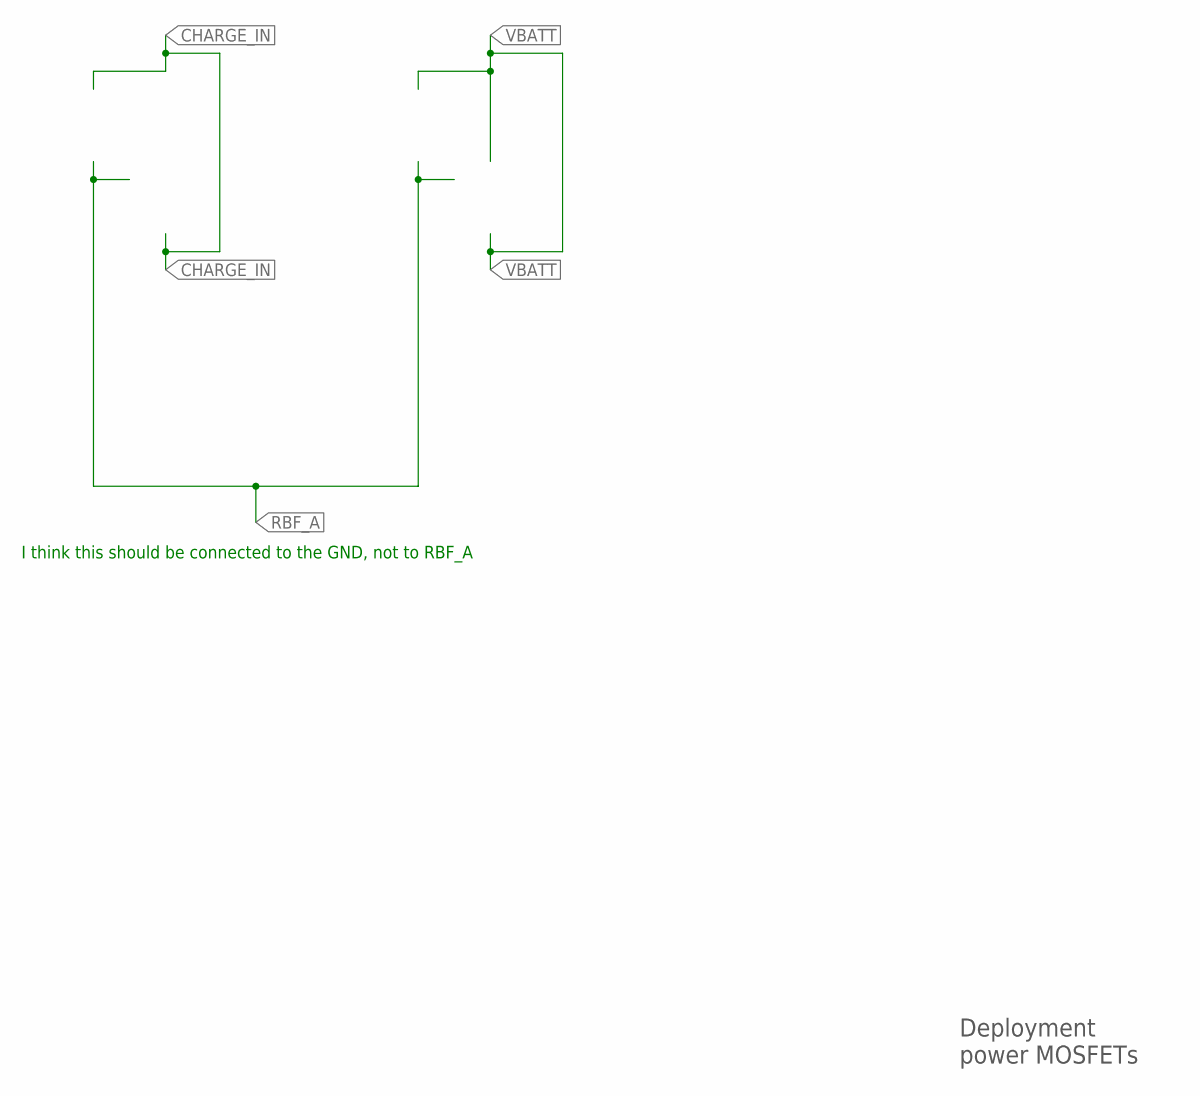
[picture p17: schematic power-board.sch, sheet 17, Deployment]

Notes on the sheet:
Deployment power MOSFETs
I think this should be connected to the GND, not to RBF_A

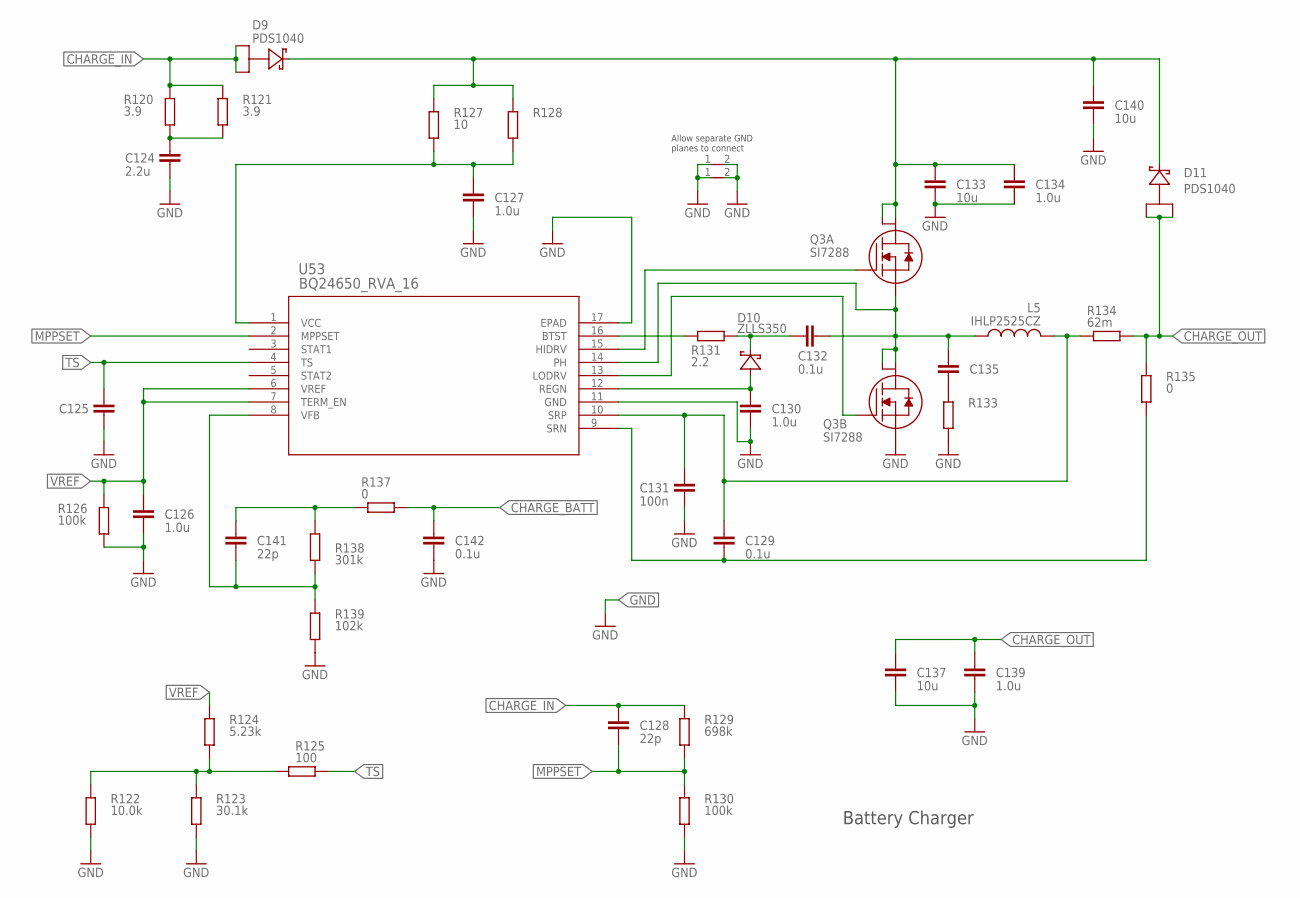
[picture p18: schematic power-board.sch, sheet 18, Battery Charger]

Parts:
C124: 2.2u; C1210
C125: C0603; P0603
C126, C127, C130, C139: 1.0u; P0805
C128, C141: 22p; P0603
C129, C132, C142: 0.1u; P0603
C131: 100n; P0603
C133, C140: 10u; C1210
C134: 1.0u; C0805
C135: C-EUC0603; C0603
C137: 10u; P1210
D9, D11: PDS1040; POWERDI5
D10: ZLLS350; SOD-523
L5: IHLP2525CZ
Q3: SI7288; SO8-POWERPAK_DUAL
R120, R121: 3.9; R0603
R122: 10.0k; P0603
R123: 30.1k; P0603
R124: 5.23k; P0603
R125: 100; P0603
R126, R130: 100k; P0603
R127: 10; P0805
R128, R133: R0805; P0805
R129: 698k; P0603
R131: 2.2; P0603
R134: 62m; R1206
R135, R137: 0; P0603
R138: 301k; P0603
R139: 102k; P0603
SH1, SH2: SHORT
U53: BQ24650_RVA_16; RVA16_2P14X2P14

Connections:
CHARGE_BATT: C142.1, R137.2; also elsewhere on the board
CHARGE_IN: C128.1, D9.LEFT (A1), D9.RIGHT (A2), R120.2, R121.2, R129.2; also elsewhere on the board
CHARGE_OUT: C137.1, C139.1, D11.LEFT (A1), D11.RIGHT (A2), R134.2, R135.2; also elsewhere on the board
GND: C124.2, C125.2, C126.2, C127.1, C130.2, C131.2, C133.2, C134.2, C137.2, C139.2, C140.2, C142.2, Q3.3 (S), R122.1, R123.1, R126.1, R130.1, R133.1, R139.1, SH1.1, SH1.2, SH2.1, SH2.2, U53.11 (GND), U53.17 (EPAD); also elsewhere on the board
MPPSET: C128.2, R129.1, R130.2, U53.2 (MPPSET)
unnamed: C141.1, R137.1, R138.2
unnamed: C124.1, R120.1, R121.1
unnamed: C135.2, R133.2
unnamed: C127.2, R127.1, R128.1, U53.1 (VCC)
unnamed: C130.1, D10.2 (A), U53.12 (REGN)
unnamed: C129.1, C131.1, L5.2, R134.1, U53.10 (SRP)
unnamed: C129.2, R135.1, U53.9 (SRN)
unnamed: C132.2, C135.1, L5.1, Q3.1 (S), Q3.5 (D2), Q3.PAD56 (D), U53.14 (PH)
unnamed: C132.1, D10.1 (C), R131.2
unnamed: R131.1, U53.16 (BTST)
unnamed: C141.2, R138.1, R139.2, U53.8 (VFB)
unnamed: R122.2, R123.2, R124.1, R125.1
unnamed: Q3.2 (G), U53.15 (HIDRV)
unnamed: Q3.4 (G), U53.13 (LODRV)
PROP: C133.1, C134.1, C140.1, D9.HEAT_SINK (C), D11.HEAT_SINK (C), Q3.8 (D2), Q3.PAD78 (D), R127.2, R128.2
TS: C125.1, R125.2, U53.4 (TS)
VREF: C126.1, R124.2, R126.2, U53.6 (VREF), U53.7 (TERM_EN)

Notes on the sheet:
Battery Charger
Allow separate GND planes to connect
