mattbrejza/cubesat-pwr/board/power-board.brd

## EAGLE design board/power-board.brd (continued)

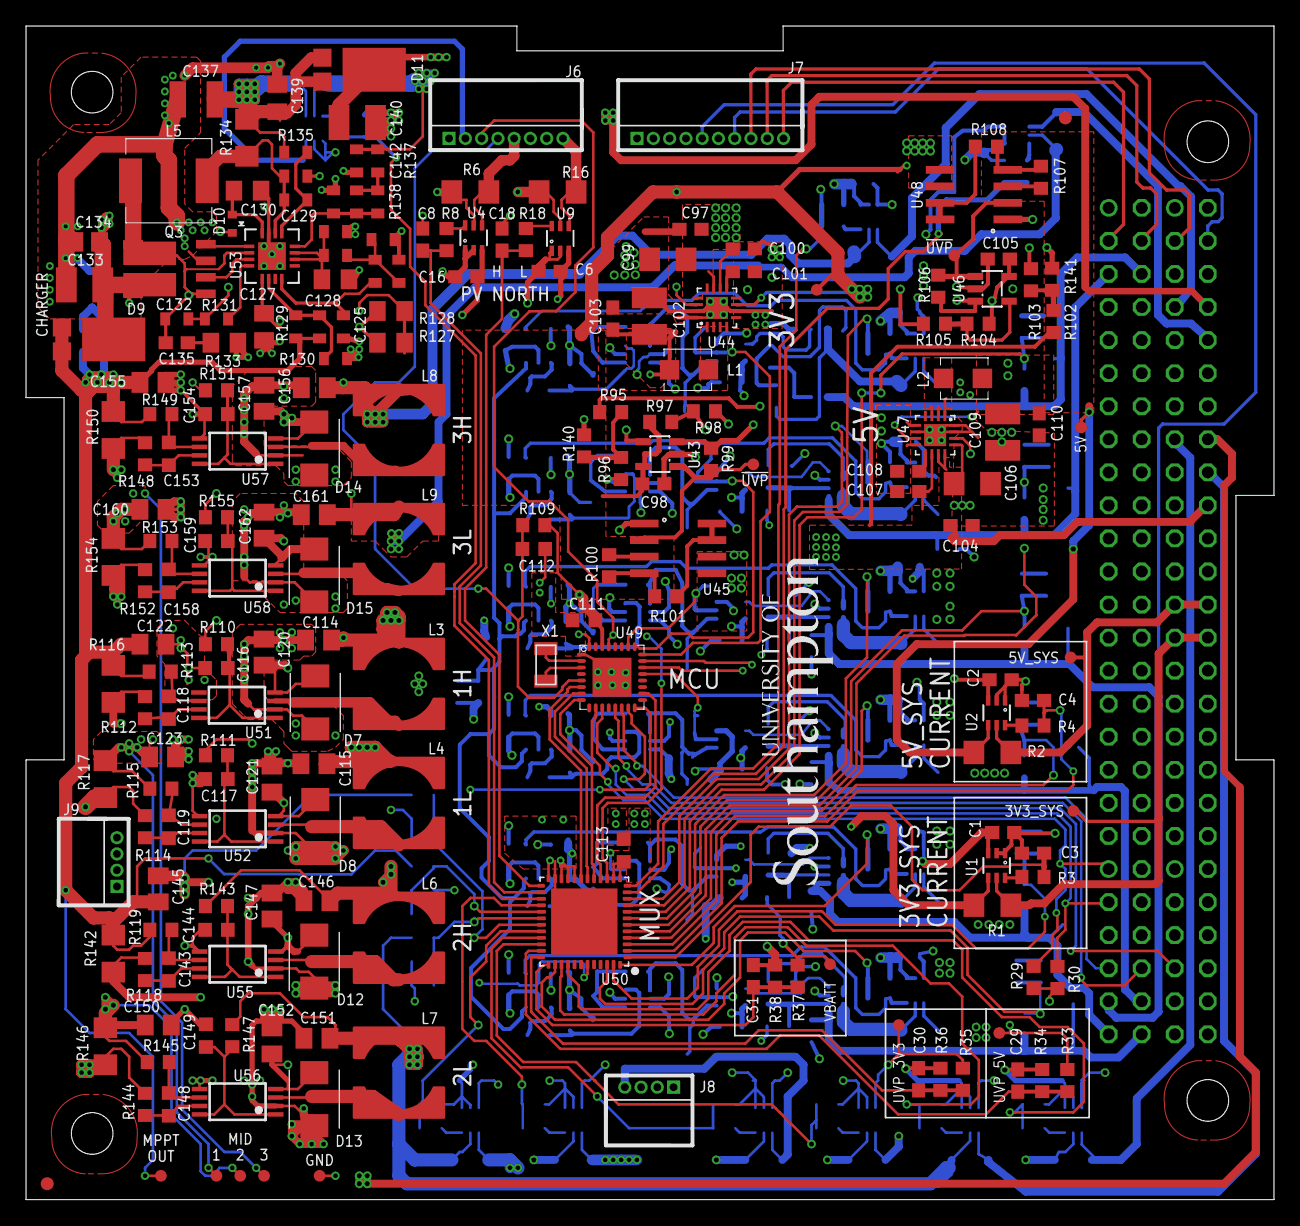
[picture p19: board power-board.brd from above]

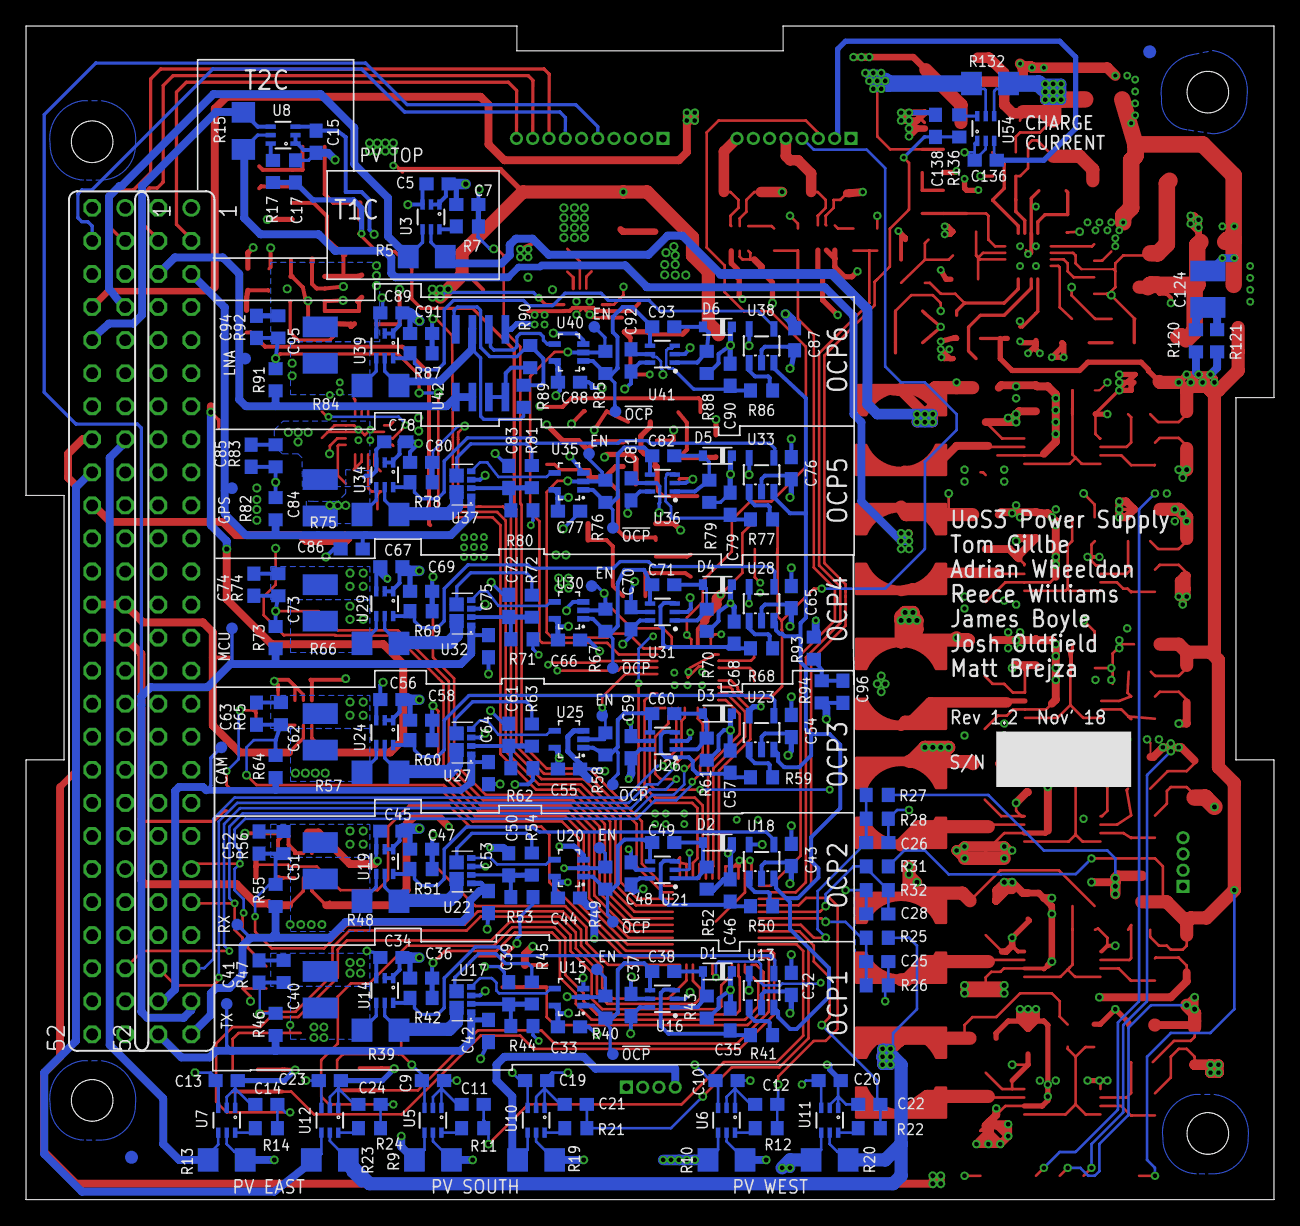
[picture p20: board power-board.brd from below]

Board: 4 copper layers, 95.9 x 90.2 mm, 445 parts (236 on the bottom side), 224 nets.

Other parts of the board:
U$1: UOS_LOGO_SML
