mattbrejza/cubesat-pwr/(commit log)

2017-03-10 removing deployment switches, adding testpoints
    [power-board.brd, power-board.sch]
2017-03-13 done (hopefully)
    [power-board.brd, power-board.sch]
2018-02-24 committing WIP
    [power-board.brd, power-board.sch]
2018-05-03 various bits of routing over a period of time
    [power-board.brd, power-board.sch]
2018-05-07 some routing
    [power-board.brd]
2018-05-10 some more routing
    [power-board.brd]
2018-05-18 changing mppt voltage monitoring points
    [power-board.brd, power-board.sch]
2018-05-19 no airwires
    [power-board.brd, power-board.sch]
2018-07-01 separating vbat/charge. routing improvements for 3.3/5V regs
    [power-board.brd, power-board.sch]
2018-07-01 updating component values
    [power-board.brd, power-board.sch]
2018-11-04 adding i2c pullups
    [power-board.brd, power-board.sch]
2018-11-04 fixing silk layer
    [power-board.brd]
2018-11-06 updated UVP componets to 7.2V/8V to match changes to the previous board. Also increased the UVP components by 10x to reduce current consumption
    [power-board.brd, power-board.sch]
2018-11-06 adding gerbers
